tigercraft4/SHS-Z2M-Presence/.planning/phases/04-code-restructuring/04-03-PLAN.md

---
phase: 04-code-restructuring
plan: 03
type: execute
wave: 3
depends_on: ["04-01", "04-02"]
files_modified:
  - main/shs_config.h
  - main/shs_config.c
  - main/shs_sensor.h
  - main/shs_sensor.c
  - main/shs_button.h
  - main/shs_button.c
  - main/shs01.c
autonomous: true
requirements:
  - CS-02
  - CS-03
must_haves:
  truths:
    - "shs01.c reduced to ≤100 lines containing only app_main()"
    - "Zone attribute handler uses computed offsets instead of 30 switch cases"
    - "All sensor callbacks and tasks in shs_sensor module"
    - "Boot button task in shs_button module"
    - "Firmware compiles and produces identical Zigbee behavior"
  artifacts:
    - path: "main/shs_config.h"
      provides: "Config/NVS prototypes, attribute handler"
      contains: "shs_config_init"
    - path: "main/shs_config.c"
      provides: "NVS load/save, attribute handler with computed zone offsets, save_worker"
      contains: "shs_zb_attribute_handler"
    - path: "main/shs_sensor.h"
      provides: "Sensor task prototypes"
      contains: "shs_ld2410_task"
    - path: "main/shs_sensor.c"
      provides: "LD2410/LD2450 tasks, callbacks, zone occupancy logic"
      contains: "shs_on_ld2450_target_update"
    - path: "main/shs_button.h"
      provides: "Button task prototype"
      contains: "shs_boot_button_task"
    - path: "main/shs_button.c"
      provides: "Button task, LED flash, factory reset"
      contains: "shs_flash_led"
    - path: "main/shs01.c"
      provides: "Slim app_main only"
      min_lines: 30
  key_links:
    - from: "main/shs_config.c"
      to: "main/shs_zigbee.h"
      via: "attribute handler calls ZB helpers"
      pattern: "shs_zb_set_ou_delay_ep2"
    - from: "main/shs_sensor.c"
      to: "main/shs_zigbee.h"
      via: "sensor callbacks call ZB report functions"
      pattern: "shs_zb_set_binary_value"
    - from: "main/shs01.c"
      to: "main/shs_state.h"
      via: "app_main allocates and inits state"
      pattern: "shs_state_init"
---

<objective>
Create the remaining 3 modules (config, sensor, button) and reduce shs01.c to a slim app_main.

Purpose: Complete the module split (CS-02). Config module implements zone handler de-duplication with computed offsets (CS-03). All sensor and button logic moves to dedicated modules. shs01.c becomes the integration hub calling init functions.
Output: 6 new files + rewritten shs01.c (~80 lines)
</objective>

<execution_context>
@~/.copilot/get-shit-done/workflows/execute-plan.md
@~/.copilot/get-shit-done/templates/summary.md
</execution_context>

<context>
@.planning/PROJECT.md
@.planning/ROADMAP.md
@.planning/phases/04-code-restructuring/04-CONTEXT.md
@.planning/phases/04-code-restructuring/04-01-SUMMARY.md
@.planning/phases/04-code-restructuring/04-02-SUMMARY.md
</context>

<tasks>

<task type="auto">
  <name>Task 1: Create shs_config module with zone handler de-duplication (CS-03)</name>
  <files>main/shs_config.h, main/shs_config.c</files>
  <read_first>main/shs01.c (lines 309-690 — NVS helpers, zone save/load, zone apply; lines 1596-2020 — attribute handler with 30 zone switch cases), main/shs_state.h, main/shs_zigbee.h, main/shs01.h</read_first>
  <action>
**shs_config.h:**
```c
#ifndef SHS_CONFIG_H
#define SHS_CONFIG_H
#include "shs_state.h"
#include "esp_zigbee_core.h"

void shs_config_init(shs_state_t *state);
void shs_cfg_load_from_nvs(void);
void shs_zone_cfg_load_from_nvs(void);
void shs_zone_cfg_check_pending(void);
void shs_zone_cfg_schedule_apply(void);
void shs_save_worker(void *pv);

/* Zigbee action handler (registered by zigbee module) */
esp_err_t shs_zb_action_handler(esp_zb_core_action_callback_id_t callback_id, const void *message);
#endif
```

**shs_config.c:**

1. Module-static state pointer: `static shs_state_t *s_state = NULL;`

2. `shs_config_init(shs_state_t *state)` — stores state pointer.

3. Move all NVS helper functions from shs01.c:
   - `shs_time_reached()` (~L309)
   - `shs_cfg_save_u16()`, `shs_cfg_save_u8()`, `shs_cfg_save_i16()` (~L313-340)
   - `shs_save_enqueue()` (~L340)
   - `shs_cfg_sync_sens_proxies()` (~L346)
   - `shs_cfg_load_from_nvs()` (~L355)
   - `shs_zone_cfg_save_to_nvs()` (~L410) — the blob-based version from Phase 3
   - `shs_zone_cfg_load_from_nvs()` (~L454) — blob-first with legacy fallback
   - `shs_zone_cfg_schedule_apply()`, `shs_zone_cfg_check_pending()`, `shs_zone_cfg_apply_to_sensor()` (~L573-690)
   - `shs_apply_ld2410_config()` (~L1596)
   All functions change global access to `s_state->` fields.

4. **Zone attribute handler de-duplication (CS-03):**

   Replace the 30 copy-paste zone switch cases (~L1790-2015) with computed offset logic:

   ```c
   /* Zone attribute range: zone 1 = 0x0021-0x0027, zone N = 0x0020 + N*0x10 to +0x06 */
   static esp_err_t handle_zone_attr(uint16_t attr_id, uint8_t v8, int16_t v16s) {
       int zone_idx = -1;
       int field_offset = -1;

       if (attr_id >= SHS_ATTR_ZONE1_ENABLED && attr_id <= SHS_ATTR_ZONE1_TYPE_CFG) {
           zone_idx = 0;
           field_offset = attr_id - SHS_ATTR_ZONE1_ENABLED;
       } else {
           for (int z = 1; z < SHS_NUM_ZONES; z++) {
               uint16_t base = 0x0020 + z * 0x10;  /* zone2=0x0030, zone3=0x0040, etc. */
               if (attr_id >= base && attr_id <= base + 6) {
                   zone_idx = z;
                   field_offset = attr_id - base;
                   break;
               }
           }
       }

       if (zone_idx < 0) return ESP_ERR_NOT_FOUND;

       shs_zone_t *zone = &s_state->zones[zone_idx];
       if (xSemaphoreTake(s_state->zone_config_mutex, pdMS_TO_TICKS(50)) != pdTRUE)
           return ESP_OK;

       switch (field_offset) {
           case 0: zone->enabled = (v8 != 0); break;       /* ENABLED offset */
           case 1: zone->x1 = v16s; break;                  /* X1 offset */
           case 2: zone->y1 = v16s; break;                  /* Y1 offset */
           case 3: zone->x2 = v16s; break;                  /* X2 offset */
           case 4: zone->y2 = v16s; break;                  /* Y2 offset */
           /* case 5: targets — read-only, skip */
           case 6: zone->type = v8; break;                   /* TYPE offset */
           default: break;
       }
       xSemaphoreGive(s_state->zone_config_mutex);

       ESP_LOGI(TAG, "Zone %d field %d updated", zone_idx + 1, field_offset);
       shs_zone_cfg_schedule_apply();
       return ESP_OK;
   }
   ```

   This replaces ~220 lines of switch cases with ~30 lines. The attribute handler's config cluster section calls `handle_zone_attr()` for any attr_id >= 0x0020 that isn't in the non-zone config range.

5. Move `shs_zb_attribute_handler()` (~L1633) — the entire function. Non-zone cases (movement cooldown, occupancy clear, sensitivities, gates, position_reporting, min energy) stay as individual switch cases. Zone cases get replaced with the single `handle_zone_attr()` call.

6. Move `shs_zb_action_handler()` (~L2022) — wraps attribute handler callback.

7. Move `shs_save_worker()` (~L3261) — debounce logic, NVS write handling.
  </action>
  <acceptance_criteria>
    - main/shs_config.c contains `static esp_err_t handle_zone_attr(` function
    - main/shs_config.c does NOT contain `case SHS_ATTR_ZONE2_ENABLED` or any zone 2-5 individual switch cases
    - main/shs_config.c contains `s_state->zones[zone_idx]` zone array access
    - main/shs_config.c contains `shs_zone_cfg_save_to_nvs` with blob-based save
    - main/shs_config.c contains `shs_save_worker` function
    - main/shs_config.h contains `shs_zb_action_handler` prototype
  </acceptance_criteria>
  <verify>
    <automated>Select-String "case SHS_ATTR_ZONE[2-5]" main/shs_config.c should return 0 matches (zone duplication eliminated)</automated>
  </verify>
  <done>Config module compiles, zone handler uses computed offsets (CS-03), NVS save/load works via s_state</done>
</task>

<task type="auto">
  <name>Task 2: Create shs_sensor and shs_button modules + slim shs01.c</name>
  <files>main/shs_sensor.h, main/shs_sensor.c, main/shs_button.h, main/shs_button.c, main/shs01.c</files>
  <read_first>main/shs01.c (lines 769-1600 — sensor callbacks and processing; lines 2040-2215 — button task; lines 2272-2440 — sensor tasks; lines 3321-3400 — app_main), main/shs_state.h, main/shs_zigbee.h, main/shs_config.h, main/shs01.h</read_first>
  <action>
**shs_sensor.h:**
```c
#ifndef SHS_SENSOR_H
#define SHS_SENSOR_H
#include "shs_state.h"

void shs_sensor_init(shs_state_t *state);
void shs_ld2410_task(void *pvParameters);
void shs_ld2450_task(void *pvParameters);
#endif
```

**shs_sensor.c:**

1. Module-static: `static shs_state_t *s_state = NULL;`
2. `shs_sensor_init(shs_state_t *state)` — stores pointer.
3. Move all sensor code from shs01.c:
   - `is_valid_target()` (~L973)
   - `shs_point_in_zone()` (~L989)
   - `shs_target_in_interference_zone()` (~L998)
   - `shs_on_ld2450_target_update()` (~L1032) — the big target processing function. Zone access changes from `shs_zone1_x1` to `s_state->zones[0].x1`. The zone checking loop already iterates — this benefits most from the array. The 5× copy-paste zone-occupied checks collapse to a single `for (int z = 0; z < SHS_NUM_ZONES; z++)` loop.
   - `shs_on_ld2450_zone_update()` (~L1187)
   - `shs_ld2450_force_update()` (~L1310) — zone reporting uses loop over `s_state->zones[i]`
   - `shs_ld2410c_force_update()` (~L1445)
   - `shs_on_state_change()` (~L769) — LD2410C callback
   - `shs_ld2410_task()` (~L2272) — TWDT subscription, frame timeout monitoring
   - `shs_ld2450_task()` (~L2334) — TWDT subscription, connect/disconnect, health reporting
   All functions change global access to `s_state->` fields. ZB helper calls change to use the public API from shs_zigbee.h (already non-static in Plan 02).

**shs_button.h:**
```c
#ifndef SHS_BUTTON_H
#define SHS_BUTTON_H
#include "shs_state.h"

void shs_button_init(shs_state_t *state);
void shs_boot_button_task(void *pv);
#endif
```

**shs_button.c:**

1. Module-static: `static shs_state_t *s_state = NULL;`
2. `shs_button_init(shs_state_t *state)` — stores pointer.
3. Move from shs01.c:
   - `shs_flash_led()` (~L2040)
   - `shs_boot_button_task()` (~L2049) — factory reset, position toggle
   All global access → `s_state->`.

**Rewrite shs01.c to slim app_main (~80 lines):**

Replace the entire current 2980-line shs01.c with:

```c
/*
 * SHS01 Presence Sensor — Application Entry Point
 */

#include <string.h>
#include "esp_log.h"
#include "nvs_flash.h"
#include "freertos/FreeRTOS.h"
#include "freertos/task.h"
#include "esp_task_wdt.h"

#include "shs01.h"
#include "shs_state.h"
#include "shs_config.h"
#include "shs_zigbee.h"
#include "shs_sensor.h"
#include "shs_button.h"
#include "light_driver.h"

static const char *TAG = "SHS01";

/* Application state — single allocation, shared by all modules */
static shs_state_t g_state;

void app_main(void) {
    ESP_LOGI(TAG, "SHS01 Presence Sensor starting...");

    /* Initialize NVS */
    esp_err_t ret = nvs_flash_init();
    if (ret == ESP_ERR_NVS_NO_FREE_PAGES || ret == ESP_ERR_NVS_NEW_VERSION_FOUND) {
        ESP_ERROR_CHECK(nvs_flash_erase());
        ret = nvs_flash_init();
    }
    ESP_ERROR_CHECK(ret);

    /* Initialize shared state */
    shs_state_init(&g_state);

    /* Initialize modules (order matters — stores state pointer) */
    shs_config_init(&g_state);
    shs_zigbee_init(&g_state);
    shs_sensor_init(&g_state);
    shs_button_init(&g_state);

    /* Load configuration from NVS */
    shs_cfg_load_from_nvs();
    shs_zone_cfg_load_from_nvs();

    /* Initialize LED */
    light_driver_init(false);

    /* Initialize task watchdog (Phase 3: 10s timeout, panic on trigger) */
    esp_task_wdt_config_t twdt_config = {
        .timeout_ms = 10000,
        .trigger_panic = true,
        .idle_core_mask = 0,
    };
    ESP_ERROR_CHECK(esp_task_wdt_init(&twdt_config));

    /* Create tasks */
    xTaskCreate(shs_zigbee_task, "zigbee", 4096, NULL, 5, NULL);
    xTaskCreate(shs_ld2410_task, "ld2410", 3072, NULL, 4, NULL);
    xTaskCreate(shs_ld2450_task, "ld2450", 4096, NULL, 4, NULL);
    xTaskCreate(shs_boot_button_task, "button", 2048, NULL, 3, NULL);
    xTaskCreate(shs_save_worker, "save", 3072, NULL, 3, NULL);

    ESP_LOGI(TAG, "All tasks started");
}
```

Delete all other content from shs01.c. The file should be ~60-80 lines total.
  </action>
  <acceptance_criteria>
    - main/shs_sensor.c contains `shs_on_ld2450_target_update` with `s_state->zones[` array access
    - main/shs_sensor.c contains `shs_ld2410_task` and `shs_ld2450_task`
    - main/shs_button.c contains `shs_flash_led` and `shs_boot_button_task`
    - main/shs01.c is ≤100 lines
    - main/shs01.c contains `shs_state_init(&g_state)` and `static shs_state_t g_state`
    - main/shs01.c contains all 5 `xTaskCreate` calls
    - main/shs01.c does NOT contain `static bool shs_moving_state` or any sensor globals
  </acceptance_criteria>
  <verify>
    <automated>(Get-Content main/shs01.c | Measure-Object -Line).Lines should be ≤ 100</automated>
  </verify>
  <done>All 5 modules created, shs01.c is slim app_main only, firmware compiles with identical behavior</done>
</task>

</tasks>

<threat_model>
## Trust Boundaries

| Boundary | Description |
|---|---|
| Zigbee coordinator → attribute handler | Incoming attribute writes are validated in shs_config.c (type checks + range clamps) |
| UART → sensor callbacks | LD2410C/LD2450 UART data parsed by driver components (unchanged) |

## STRIDE Threat Register

| Threat ID | Category | Component | Disposition | Mitigation Plan |
|---|---|---|---|---|
| T-04-04 | T (Tampering) | Zone attributes | mitigate | handle_zone_attr validates zone_idx bounds (0 ≤ idx < SHS_NUM_ZONES) before array access |
| T-04-05 | I (Info Disclosure) | Diagnostic counters | accept | Counters are intentionally exposed via Zigbee for monitoring — no PII |
| T-04-06 | E (Elevation) | Module init order | mitigate | app_main enforces init order: state → config → zigbee → sensor → button. Each init stores s_state pointer — NULL if called out of order |
</threat_model>

<verification>
- shs01.c line count ≤ 100
- No sensor globals remain in shs01.c
- Zone target update uses loop over zones[] array (not 5× copy-paste)
- All 25 endpoints still created (verified by endpoint count in zigbee interview)
- Factory reset still works (button task in separate module)
</verification>

<success_criteria>
- shs01.c contains only app_main() (~80 lines) (CS-02)
- Zone attribute handler uses computed offsets (~30 lines vs ~220 lines) (CS-03)
- All modules compile, firmware behavior identical to pre-refactor
</success_criteria>

<output>
After completion, create `.planning/phases/04-code-restructuring/04-03-SUMMARY.md`
</output>
