tigercraft4/SHS-Z2M-Presence/.planning/phases/03-reliability-diagnostics/03-01-PLAN.md

---
phase: 03-reliability-diagnostics
plan: 01
type: execute
wave: 1
depends_on: []
files_modified:
  - sdkconfig.defaults
  - main/shs01.c
autonomous: true
requirements: [SH-01, NVS-02, NVS-03]

must_haves:
  truths:
    - "Task watchdog monitors both sensor tasks with 10s timeout"
    - "Frozen sensor task triggers automatic device reboot"
    - "LD2410C disconnect detected via UART frame timeout (3s threshold)"
    - "Zone config save uses single NVS blob key — atomic on power loss"
    - "NVS write failures logged and handled gracefully"
  artifacts:
    - path: "sdkconfig.defaults"
      provides: "TWDT configuration"
      contains: "CONFIG_ESP_TASK_WDT_EN=y"
    - path: "main/shs01.c"
      provides: "TWDT init, sensor reset calls, NVS blob batching"
  key_links:
    - from: "shs_ld2410_task loop"
      to: "esp_task_wdt_reset()"
      via: "called every 20ms iteration"
      pattern: "esp_task_wdt_reset"
    - from: "shs_ld2450_task loop"
      to: "esp_task_wdt_reset()"
      via: "called every 20ms iteration"
      pattern: "esp_task_wdt_reset"
    - from: "shs_zone_cfg_save_to_nvs"
      to: "nvs_set_blob"
      via: "packed struct serialization"
      pattern: "nvs_set_blob"
---

<objective>
Add task watchdog monitoring for sensor tasks and batch zone NVS writes into a single atomic blob.

Purpose: Detect frozen sensor tasks (UART hardware hangs) and ensure zone configuration is never partially written on power loss.
Output: TWDT-protected sensor loops + atomic NVS zone persistence + LD2410C disconnect detection via frame timestamps.
</objective>

<execution_context>
@~/.copilot/get-shit-done/workflows/execute-plan.md
@~/.copilot/get-shit-done/templates/summary.md
</execution_context>

<context>
@.planning/PROJECT.md
@.planning/ROADMAP.md
@.planning/STATE.md
@.planning/phases/03-reliability-diagnostics/03-CONTEXT.md
</context>

<tasks>

<task type="auto">
  <name>Task 1: Task Watchdog + LD2410C frame timestamp</name>
  <files>sdkconfig.defaults, main/shs01.c</files>
  <read_first>
    - sdkconfig.defaults (current config entries)
    - main/shs01.c §L3160-3230 (app_main — initialization order)
    - main/shs01.c §L2169-2210 (shs_ld2410_task — loop structure)
    - main/shs01.c §L2213-2310 (shs_ld2450_task — loop structure)
  </read_first>
  <action>
**sdkconfig.defaults** — append TWDT config (per D-01, D-03, D-04):
```
# Task Watchdog
CONFIG_ESP_TASK_WDT_EN=y
CONFIG_ESP_TASK_WDT_PANIC=y
CONFIG_ESP_TASK_WDT_TIMEOUT_S=10
CONFIG_ESP_TASK_WDT_CHECK_IDLE_TASK=n
```
`CHECK_IDLE_TASK=n` because ESP32-C6 is single-core and the idle task may starve under Zigbee load.

**main/shs01.c** — add `#include "esp_task_wdt.h"` to includes.

**main/shs01.c** — add LD2410C frame timestamp tracking (per D-06):
Add near existing diagnostic counters (after line ~149):
```c
/* LD2410C health monitoring — frame-based disconnect detection (D-06) */
static uint32_t shs_ld2410c_last_frame_ms = 0;
static bool shs_ld2410c_connected = false;
#define SHS_LD2410C_FRAME_TIMEOUT_MS  3000  /* 3s = ~30 missed frames at 100ms interval */
```

**main/shs01.c** — in `app_main()`, after mutex creation and before `xTaskCreate(shs_zigbee_task, ...)`:
```c
/* Initialize Task Watchdog Timer (per D-01, D-03, D-04) */
esp_task_wdt_config_t twdt_config = {
    .timeout_ms = 10000,
    .idle_core_mask = 0,
    .trigger_panic = true,
};
ESP_ERROR_CHECK(esp_task_wdt_init(&twdt_config));
ESP_LOGI(SHS_TAG, "Task watchdog initialized (10s timeout, panic on trigger)");
```

**main/shs01.c** — in `shs_ld2410_task()`, at start of function (after `shs_apply_ld2410_config()`):
```c
/* Subscribe this task to TWDT (per D-02) */
ESP_ERROR_CHECK(esp_task_wdt_add(NULL));
```
In the `while(1)` loop, after `ld2410_process()`:
```c
esp_task_wdt_reset();
```
Add LD2410C frame timestamp update — after the `ld2410_process()` + `esp_task_wdt_reset()` block, use the existing `connected` variable:
```c
/* Update LD2410C frame timestamp for disconnect detection (D-06) */
if (connected) {
    shs_ld2410c_last_frame_ms = now;
    if (!shs_ld2410c_connected) {
        shs_ld2410c_connected = true;
        ESP_LOGI(SHS_TAG, "LD2410C connected (frame received)");
    }
} else if (shs_ld2410c_connected && shs_ld2410c_last_frame_ms > 0 &&
           (now - shs_ld2410c_last_frame_ms) > SHS_LD2410C_FRAME_TIMEOUT_MS) {
    shs_ld2410c_connected = false;
    ESP_LOGW(SHS_TAG, "LD2410C disconnected (no frame for %lu ms)",
             (unsigned long)(now - shs_ld2410c_last_frame_ms));
}
```

**main/shs01.c** — in `shs_ld2450_task()`, at start of function (after `shs_zone_cfg_apply_to_sensor()`):
```c
/* Subscribe this task to TWDT (per D-02) */
ESP_ERROR_CHECK(esp_task_wdt_add(NULL));
```
In the `while(1)` loop, after `ld2450_process()`:
```c
esp_task_wdt_reset();
```
  </action>
  <verify>
    <automated>grep -c "esp_task_wdt" main/shs01.c</automated>
  </verify>
  <acceptance_criteria>
    - sdkconfig.defaults contains `CONFIG_ESP_TASK_WDT_EN=y`
    - sdkconfig.defaults contains `CONFIG_ESP_TASK_WDT_PANIC=y`
    - sdkconfig.defaults contains `CONFIG_ESP_TASK_WDT_TIMEOUT_S=10`
    - shs01.c contains `#include "esp_task_wdt.h"`
    - shs01.c contains `esp_task_wdt_init` call in app_main
    - shs01.c contains `esp_task_wdt_add(NULL)` in shs_ld2410_task
    - shs01.c contains `esp_task_wdt_add(NULL)` in shs_ld2450_task
    - shs01.c contains `esp_task_wdt_reset()` in both sensor task loops
    - shs01.c contains `SHS_LD2410C_FRAME_TIMEOUT_MS` define (3000)
    - shs01.c contains `shs_ld2410c_connected` variable
  </acceptance_criteria>
  <done>Both sensor tasks subscribed to TWDT. LD2410C disconnect detection via 3s frame timeout. Device will auto-reboot if either sensor task freezes for 10s.</done>
</task>

<task type="auto">
  <name>Task 2: NVS zone config batching + error handling</name>
  <files>main/shs01.c</files>
  <read_first>
    - main/shs01.c §L390-440 (shs_zone_cfg_save_to_nvs — current 31-write implementation)
    - main/shs01.c §L440-520 (shs_zone_cfg_load_from_nvs — current per-key loading)
    - main/shs01.c §L3100-3160 (shs_save_worker — zone save case handler)
    - main/shs01.c §L280-340 (NVS helper functions)
    - main/shs01.c §L3206 (save_worker stack size 3072)
  </read_first>
  <action>
**NVS batching with blob** (per D-09 choosing blob approach, D-10 atomicity):

Define a packed struct near the zone config section:
```c
/* Packed zone config for atomic NVS blob save (D-10) */
typedef struct __attribute__((packed)) {
    uint8_t zone_type;
    struct __attribute__((packed)) {
        uint8_t enabled;
        int16_t x1, y1, x2, y2;
        uint8_t type;
    } zones[5];
} shs_zone_cfg_blob_t;  /* 51 bytes — safe for 3072B save_worker stack */

#define SHS_NVS_KEY_ZONE_BLOB "zone_blob"
```

**Replace `shs_zone_cfg_save_to_nvs()`** — the entire function body becomes:
```c
static void shs_zone_cfg_save_to_nvs(void) {
    shs_zone_cfg_blob_t blob;
    blob.zone_type = shs_zone_type;

    /* Pack zone data — read under zone_config_mutex assumed by caller (save_worker) */
    const bool     *en[]  = {&shs_zone1_enabled, &shs_zone2_enabled, &shs_zone3_enabled, &shs_zone4_enabled, &shs_zone5_enabled};
    const int16_t  *x1[]  = {&shs_zone1_x1, &shs_zone2_x1, &shs_zone3_x1, &shs_zone4_x1, &shs_zone5_x1};
    const int16_t  *y1[]  = {&shs_zone1_y1, &shs_zone2_y1, &shs_zone3_y1, &shs_zone4_y1, &shs_zone5_y1};
    const int16_t  *x2[]  = {&shs_zone1_x2, &shs_zone2_x2, &shs_zone3_x2, &shs_zone4_x2, &shs_zone5_x2};
    const int16_t  *y2[]  = {&shs_zone1_y2, &shs_zone2_y2, &shs_zone3_y2, &shs_zone4_y2, &shs_zone5_y2};
    const uint8_t  *tp[]  = {&shs_zone1_type, &shs_zone2_type, &shs_zone3_type, &shs_zone4_type, &shs_zone5_type};

    for (int i = 0; i < 5; i++) {
        blob.zones[i].enabled = *en[i] ? 1 : 0;
        blob.zones[i].x1 = *x1[i];
        blob.zones[i].y1 = *y1[i];
        blob.zones[i].x2 = *x2[i];
        blob.zones[i].y2 = *y2[i];
        blob.zones[i].type = *tp[i];
    }

    nvs_handle_t h;
    esp_err_t err = nvs_open("shs_cfg", NVS_READWRITE, &h);
    if (err != ESP_OK) {
        ESP_LOGW(SHS_TAG, "NVS open failed for zone save: %s", esp_err_to_name(err));
        return;
    }

    err = nvs_set_blob(h, SHS_NVS_KEY_ZONE_BLOB, &blob, sizeof(blob));
    if (err != ESP_OK) {
        ESP_LOGW(SHS_TAG, "NVS zone blob write failed: %s", esp_err_to_name(err));
        nvs_close(h);
        return;
    }

    err = nvs_commit(h);
    if (err != ESP_OK) {
        ESP_LOGW(SHS_TAG, "NVS zone blob commit failed: %s", esp_err_to_name(err));
    }
    nvs_close(h);
    ESP_LOGI(SHS_TAG, "Zone config saved to NVS (atomic blob, %u bytes)", (unsigned)sizeof(blob));
}
```

**Update `shs_zone_cfg_load_from_nvs()`** — try blob first, fall back to legacy keys for migration (per D-11 error handling):
```c
static void shs_zone_cfg_load_from_nvs(void) {
    nvs_handle_t h;
    if (nvs_open("shs_cfg", NVS_READONLY, &h) != ESP_OK) {
        ESP_LOGI(SHS_TAG, "No zone config in NVS, using defaults");
        return;
    }

    /* Try blob format first (new atomic format) */
    shs_zone_cfg_blob_t blob;
    size_t blob_len = sizeof(blob);
    esp_err_t err = nvs_get_blob(h, SHS_NVS_KEY_ZONE_BLOB, &blob, &blob_len);
    if (err == ESP_OK && blob_len == sizeof(blob)) {
        shs_zone_type = blob.zone_type;
        bool     *en[]  = {&shs_zone1_enabled, &shs_zone2_enabled, &shs_zone3_enabled, &shs_zone4_enabled, &shs_zone5_enabled};
        int16_t  *x1[]  = {&shs_zone1_x1, &shs_zone2_x1, &shs_zone3_x1, &shs_zone4_x1, &shs_zone5_x1};
        int16_t  *y1[]  = {&shs_zone1_y1, &shs_zone2_y1, &shs_zone3_y1, &shs_zone4_y1, &shs_zone5_y1};
        int16_t  *x2[]  = {&shs_zone1_x2, &shs_zone2_x2, &shs_zone3_x2, &shs_zone4_x2, &shs_zone5_x2};
        int16_t  *y2[]  = {&shs_zone1_y2, &shs_zone2_y2, &shs_zone3_y2, &shs_zone4_y2, &shs_zone5_y2};
        uint8_t  *tp[]  = {&shs_zone1_type, &shs_zone2_type, &shs_zone3_type, &shs_zone4_type, &shs_zone5_type};
        for (int i = 0; i < 5; i++) {
            *en[i] = blob.zones[i].enabled ? true : false;
            *x1[i] = blob.zones[i].x1;
            *y1[i] = blob.zones[i].y1;
            *x2[i] = blob.zones[i].x2;
            *y2[i] = blob.zones[i].y2;
            *tp[i] = blob.zones[i].type;
        }
        nvs_close(h);
        ESP_LOGI(SHS_TAG, "Zone config loaded from NVS (blob format)");
        return;
    }

    /* Fall back to legacy per-key format (migration path) */
    ESP_LOGI(SHS_TAG, "No zone blob in NVS, trying legacy keys...");
    /* ... keep the existing per-key loading code below this point ... */
```
Keep ALL existing per-key `nvs_get_*` calls after this fallback comment — they handle pre-blob firmware configs. After loading from legacy keys, close NVS and then trigger a blob save to migrate:
```c
    nvs_close(h);
    ESP_LOGI(SHS_TAG, "Zone config loaded from NVS (legacy format, will migrate to blob)");
    /* Migrate to blob format on next save */
    shs_zone_cfg_save_to_nvs();
}
```

**NVS error handling** (per D-11): All `nvs_open`/`nvs_set_*`/`nvs_commit` calls in the helper functions (`shs_cfg_save_u16`, `shs_cfg_save_u8`, `shs_cfg_save_i16`) should log warnings on failure. Currently they silently return. Add `ESP_LOGW` on failure to each helper:
- `shs_cfg_save_u16`: change `if (nvs_open(...) != ESP_OK) return;` to `if (... != ESP_OK) { ESP_LOGW(SHS_TAG, "NVS save_u16 open failed: %s", esp_err_to_name(err)); return; }` — capture err from nvs_open.
- Same pattern for `shs_cfg_save_u8` and `shs_cfg_save_i16`.
  </action>
  <verify>
    <automated>grep -c "nvs_set_blob\|zone_blob\|shs_zone_cfg_blob_t\|ESP_LOGW.*NVS" main/shs01.c</automated>
  </verify>
  <acceptance_criteria>
    - shs01.c contains `shs_zone_cfg_blob_t` typedef with `__attribute__((packed))`
    - shs01.c contains `SHS_NVS_KEY_ZONE_BLOB` define as "zone_blob"
    - shs_zone_cfg_save_to_nvs uses `nvs_set_blob` (not 31 individual nvs_set calls)
    - shs_zone_cfg_load_from_nvs tries `nvs_get_blob` first, falls back to legacy keys
    - NVS helper functions (`shs_cfg_save_u16`, `shs_cfg_save_u8`, `shs_cfg_save_i16`) log `ESP_LOGW` on open/write failures
    - No `nvs_set_u8` or `nvs_set_i16` calls remain in `shs_zone_cfg_save_to_nvs`
  </acceptance_criteria>
  <done>Zone config saves atomically via single NVS blob (51 bytes). Legacy per-key configs auto-migrate on first boot. All NVS failures logged with ESP_LOGW.</done>
</task>

</tasks>

<threat_model>
## Trust Boundaries

| Boundary | Description |
|---|---|
| NVS flash ↔ firmware | NVS blob could be corrupted (flash wear, power loss during write) |
| UART ↔ sensor tasks | Sensor hardware can hang, stop sending frames |

## STRIDE Threat Register

| Threat ID | Category | Component | Disposition | Mitigation Plan |
|---|---|---|---|---|
| T-03-01 | D (Denial of Service) | shs_ld2410_task / shs_ld2450_task | mitigate | TWDT auto-reboot on frozen task (10s timeout, CONFIG_ESP_TASK_WDT_PANIC=y) |
| T-03-02 | T (Tampering) | NVS zone_blob | accept | NVS corruption handled by load fallback to defaults; mains-powered device, flash wear is low risk |
| T-03-03 | D (Denial of Service) | NVS write failure | mitigate | Log warning + continue with in-memory values; device operates normally without persistent save |
</threat_model>

<verification>
- `grep "CONFIG_ESP_TASK_WDT" sdkconfig.defaults` returns 4 entries
- `grep -c "esp_task_wdt_reset" main/shs01.c` returns >= 2 (one per sensor task)
- `grep -c "esp_task_wdt_add" main/shs01.c` returns >= 2
- `grep "nvs_set_blob" main/shs01.c` returns at least 1 match
- `grep "nvs_get_blob" main/shs01.c` returns at least 1 match
- No `nvs_set_u8\|nvs_set_i16` calls inside `shs_zone_cfg_save_to_nvs` function
- `idf.py build` compiles without errors
</verification>

<success_criteria>
- Device reboots automatically when a sensor task freezes for 10+ seconds
- LD2410C disconnect detected passively via frame timeout (3 seconds = ~30 missed frames)
- Zone configuration saved as single 51-byte NVS blob — atomic on power loss
- Pre-blob NVS configs auto-migrate to blob format on first boot
- NVS failures produce ESP_LOGW log lines (never silent failures)
</success_criteria>

<output>
After completion, create `.planning/phases/03-reliability-diagnostics/03-01-SUMMARY.md`
</output>
