tigercraft4/SHS-Z2M-Presence/.planning/phases/02-sensor-filters/02-02-PLAN.md

---
phase: 02-sensor-filters
plan: 02
type: execute
wave: 2
depends_on:
  - 02-01
files_modified:
  - zigbee2mqtt/external_converters/shs01_enhanced.js
  - zigbee2mqtt/external_converters/shs01_enhanced.mjs
autonomous: true
requirements:
  - CC-02

must_haves:
  truths:
    - "Z2M converter reads X coordinates directly without subtracting 3000"
    - "Both .js and .mjs converters updated identically"
    - "Z2M shows correct signed X values (−3000 to +3000) after firmware + converter update"
  artifacts:
    - path: "zigbee2mqtt/external_converters/shs01_enhanced.js"
      provides: "Updated fromZigbee converter without bias subtraction"
    - path: "zigbee2mqtt/external_converters/shs01_enhanced.mjs"
      provides: "Updated ESM converter without bias subtraction"
  key_links:
    - from: "main/shs01.c (position reporting)"
      to: "zigbee2mqtt converter"
      via: "genAnalogInput presentValue on EP8-16"
      pattern: "Math.round(value)"
---

<objective>
Update Z2M external converters to match the int16 encoding change — remove the −3000 bias subtraction from X coordinate parsing.

Purpose: Plan 01 removed the +3000 bias from firmware. The converters must stop subtracting 3000 or X values will be wrong by 3000mm.
Output: Both .js and .mjs converters decode X coordinates as direct values.
</objective>

<execution_context>
@~/.copilot/get-shit-done/workflows/execute-plan.md
@~/.copilot/get-shit-done/templates/summary.md
</execution_context>

<context>
@.planning/PROJECT.md
@.planning/ROADMAP.md
@.planning/phases/02-sensor-filters/02-01-PLAN.md
@zigbee2mqtt/external_converters/shs01_enhanced.js
@zigbee2mqtt/external_converters/shs01_enhanced.mjs

<interfaces>
<!-- Current converter bias subtraction code (identical in .js and .mjs) -->

From zigbee2mqtt/external_converters/shs01_enhanced.js (lines 214-227):
```javascript
// WORKAROUND: X coordinates are transmitted with +3000 bias to avoid
// negative float issues in Zigbee stack. Subtract 3000 to restore original.
if (msg.data.hasOwnProperty('presentValue')) {
    switch (ep) {
        case EP_T1_X: result.target1_x = Math.round(value) - 3000; break;
        case EP_T1_Y: result.target1_y = Math.round(value); break;
        case EP_T1_DIST: result.target1_distance = Math.round(value); break;
        case EP_T2_X: result.target2_x = Math.round(value) - 3000; break;
        case EP_T2_Y: result.target2_y = Math.round(value); break;
        case EP_T2_DIST: result.target2_distance = Math.round(value); break;
        case EP_T3_X: result.target3_x = Math.round(value) - 3000; break;
        case EP_T3_Y: result.target3_y = Math.round(value); break;
        case EP_T3_DIST: result.target3_distance = Math.round(value); break;
    }
}
```
</interfaces>
</context>

<tasks>

<task type="auto">
  <name>Task 1: Remove bias subtraction from .js converter</name>
  <files>zigbee2mqtt/external_converters/shs01_enhanced.js</files>
  <read_first>zigbee2mqtt/external_converters/shs01_enhanced.js (lines 210-230 for the bias subtraction block)</read_first>
  <action>
1. Remove the WORKAROUND comment block (lines 214-215):
   ```
   // WORKAROUND: X coordinates are transmitted with +3000 bias to avoid
   // negative float issues in Zigbee stack. Subtract 3000 to restore original.
   ```

2. Change the three X coordinate lines to remove `- 3000`:
   - `case EP_T1_X: result.target1_x = Math.round(value) - 3000; break;`
     → `case EP_T1_X: result.target1_x = Math.round(value); break;`
   - `case EP_T2_X: result.target2_x = Math.round(value) - 3000; break;`
     → `case EP_T2_X: result.target2_x = Math.round(value); break;`
   - `case EP_T3_X: result.target3_x = Math.round(value) - 3000; break;`
     → `case EP_T3_X: result.target3_x = Math.round(value); break;`

No other changes — Y and distance lines already read values directly.
  </action>
  <verify>
    <automated>grep -n "3000" zigbee2mqtt/external_converters/shs01_enhanced.js</automated>
  </verify>
  <acceptance_criteria>
    - No `- 3000` in any `target*_x` assignment
    - No "WORKAROUND" or "bias" comment in position parsing section
    - `result.target1_x = Math.round(value);` (no subtraction)
    - `result.target2_x = Math.round(value);` (no subtraction)
    - `result.target3_x = Math.round(value);` (no subtraction)
    - Y and distance parsing unchanged: `Math.round(value)` without modification
  </acceptance_criteria>
  <done>JS converter reads X coordinates directly without bias subtraction</done>
</task>

<task type="auto">
  <name>Task 2: Remove bias subtraction from .mjs converter</name>
  <files>zigbee2mqtt/external_converters/shs01_enhanced.mjs</files>
  <read_first>zigbee2mqtt/external_converters/shs01_enhanced.mjs (lines 210-230 for the bias subtraction block)</read_first>
  <action>
Apply identical changes as Task 1 to the ESM (.mjs) converter:

1. Remove the WORKAROUND comment block.
2. Change the three X coordinate lines to remove `- 3000`:
   - `case EP_T1_X: result.target1_x = Math.round(value); break;`
   - `case EP_T2_X: result.target2_x = Math.round(value); break;`
   - `case EP_T3_X: result.target3_x = Math.round(value); break;`
  </action>
  <verify>
    <automated>grep -n "3000" zigbee2mqtt/external_converters/shs01_enhanced.mjs</automated>
  </verify>
  <acceptance_criteria>
    - No `- 3000` in any `target*_x` assignment
    - No "WORKAROUND" or "bias" comment in position parsing section
    - Changes identical to Task 1 in the .js file
  </acceptance_criteria>
  <done>MJS converter reads X coordinates directly without bias subtraction</done>
</task>

</tasks>

<threat_model>
## Trust Boundaries

| Boundary | Description |
|---|---|
| Zigbee → Z2M | Data from device parsed by converter — minimal trust concern (local network) |

## STRIDE Threat Register

| Threat ID | Category | Component | Disposition | Mitigation Plan |
|---|---|---|---|---|
| T-02-04 | T (Tampering) | Converter parsing | accept | Converter runs locally in Z2M process; external converters are user-deployed files |
</threat_model>

<verification>
- `grep -c "\- 3000" zigbee2mqtt/external_converters/shs01_enhanced.js` returns 0
- `grep -c "\- 3000" zigbee2mqtt/external_converters/shs01_enhanced.mjs` returns 0
- `grep "Math.round(value)" zigbee2mqtt/external_converters/shs01_enhanced.js | grep "target.*_x"` shows direct assignment
</verification>

<success_criteria>
- Both .js and .mjs converters decode X coordinates as direct values
- No reference to 3000 bias in converter position parsing code
- Y and distance parsing unmodified
</success_criteria>

<output>
After completion, create `.planning/phases/02-sensor-filters/02-02-SUMMARY.md`
</output>
