tigercraft4/SHS-Z2M-Presence/.planning/STATE.md

---
gsd_state_version: 1.0
milestone: v1.0
milestone_name: milestone
status: complete
stopped_at: Phase 4 complete — all 4 phases done
last_updated: "2025-01-XX"
last_activity: 2025-01-XX -- Phase 4 code restructuring complete
progress:
  total_phases: 4
  completed_phases: 4
  total_plans: 9
  completed_plans: 9
  percent: 100
---

# Project State

## Project Reference

See: .planning/PROJECT.md (updated 2026-04-30)

**Core value:** Reliable, crash-free presence detection — every occupancy event reported correctly to Zigbee2MQTT, zero silent data loss.
**Current focus:** Milestone complete

## Current Position

Phase: 4 (complete)
Plan: All 3 plans executed
Status: Milestone complete
Last activity: 2025-01-XX

Progress: [████████████████████] 100% (All phases complete)

## Performance Metrics

**Velocity:**

- Total plans completed: 9
- Average duration: —
- Total execution time: —

**By Phase:**

| Phase | Plans | Total | Avg/Plan |
|---|---|---|---|
| 1 | 2 | — | — |
| 02 | 2 | - | - |
| 03 | 2 | - | - |
| 04 | 3 | - | - |

**Recent Trend:**

- Last 5 plans: —
- Trend: —

*Updated after each plan completion*

## Accumulated Context

### Decisions

Decisions are logged in PROJECT.md Key Decisions table.
Recent decisions affecting current work:

- [Init]: Fix crash bugs before refactoring — uninitialized mutex causes immediate crash; must be first
- [Init]: Refactor into modules after bug fixes — reduces risk of introducing new bugs during restructure
- [Init]: Keep 25 endpoint model — changing endpoint count breaks existing Z2M pairings

### Pending Todos

None yet.

### Blockers/Concerns

- Zigbee lock contention: no data on actual lock hold times during commissioning/route discovery. Measure during Phase 1.
- LD2410C failure modes: no prior art in codebase for health monitoring. Characterize during Phase 3 planning.
- save_worker stack at 3072B is borderline for batched NVS. Monitor with `uxTaskGetStackHighWaterMark()`.

## Deferred Items

Items acknowledged and carried forward:

| Category | Item | Status | Deferred At |
|---|---|---|---|
| *(none)* | | | |

## Session Continuity

Last session: 2026-04-30
Stopped at: Roadmap created, ready for Phase 1 planning
Resume file: None
