tigercraft4/SHS-Z2M-Presence/.planning/phases/04-code-restructuring/04-01-SUMMARY.md

---
phase: 04-code-restructuring
plan: 01
status: complete
---

# Plan 04-01 Summary: Shared State Struct

## What Was Built
Created `shs_state.h` and `shs_state.c` — the foundation for the module split. Consolidates ~100 static globals from shs01.c into a single `shs_state_t` struct with:

- `shs_zone_t zones[SHS_NUM_ZONES]` array replacing 30+ individual zone variables
- `shs_save_evt_t` enum and `shs_save_msg_t` struct for NVS save worker
- `shs_zone_cfg_blob_t` packed struct for atomic NVS zone saves
- `shs_state_init()` creating both mutexes, save queue, and setting all defaults

## Key Files
- `main/shs_state.h` — Type definitions, constants, init prototype
- `main/shs_state.c` — Init function with mutex creation and defaults

## Decisions
- Zone defaults match existing code: x1=-1500, y1=0, x2=1500, y2=3000
- Sensor config defaults preserved exactly (moving_sens_0_100=60, etc.)
- `diag_init_zero` and `health_init_false` kept as struct fields for Zigbee attr registration

## Self-Check: PASSED
- `shs_state.h` contains `typedef struct` for shs_zone_t and shs_state_t
- `SHS_NUM_ZONES` defined as 5
- `SemaphoreHandle_t target_data_mutex` present
- `shs_zone_t zones[SHS_NUM_ZONES]` present
- `void shs_state_init(shs_state_t *state)` declared
- `shs_save_evt_t` enum and `shs_save_msg_t` struct present
