tigercraft4/SHS-Z2M-Presence/.planning/phases/04-code-restructuring/04-01-PLAN.md

---
phase: 04-code-restructuring
plan: 01
type: execute
wave: 1
depends_on: []
files_modified:
  - main/shs_state.h
  - main/shs_state.c
autonomous: true
requirements:
  - CS-01
must_haves:
  truths:
    - "shs_state_t struct compiles and contains all ~100 globals from shs01.c"
    - "shs_zone_t sub-struct has zones[SHS_NUM_ZONES] array with 8 fields per zone"
    - "shs_state_init() creates both mutexes and sets default values"
  artifacts:
    - path: "main/shs_state.h"
      provides: "shs_state_t and shs_zone_t type definitions, SHS_NUM_ZONES constant, init prototype"
      contains: "typedef struct"
    - path: "main/shs_state.c"
      provides: "shs_state_init() implementation"
      contains: "xSemaphoreCreateMutex"
  key_links:
    - from: "main/shs_state.h"
      to: "main/shs_state.c"
      via: "shs_state_init declaration/definition"
      pattern: "void shs_state_init"
---

<objective>
Create the shared state struct that all other modules will depend on.

Purpose: CS-01 requires consolidating ~100 static globals into `shs_state_t` with `shs_zone_t zones[5]` array. This is the foundation for the entire refactoring — all subsequent plans import this header.
Output: `main/shs_state.h` (types + prototypes) and `main/shs_state.c` (init function)
</objective>

<execution_context>
@~/.copilot/get-shit-done/workflows/execute-plan.md
@~/.copilot/get-shit-done/templates/summary.md
</execution_context>

<context>
@.planning/PROJECT.md
@.planning/ROADMAP.md
@.planning/STATE.md
@.planning/phases/04-code-restructuring/04-CONTEXT.md
</context>

<tasks>

<task type="auto">
  <name>Task 1: Create shs_state.h with struct definitions</name>
  <files>main/shs_state.h</files>
  <read_first>main/shs01.c (lines 44-283 — all static globals to consolidate), main/shs01.h (endpoint/attribute/cluster defines)</read_first>
  <action>
Create `main/shs_state.h` with:

1. Include guard `#ifndef SHS_STATE_H` / `#define SHS_STATE_H`
2. Required includes: `stdbool.h`, `stdint.h`, `freertos/FreeRTOS.h`, `freertos/semphr.h`, `freertos/queue.h`, `components/ld2450/include/ld2450.h` (for `ld2450_target_t`)
3. `#define SHS_NUM_ZONES 5`
4. `#define SHS_MAX_TARGETS 3`
5. `#define SHS_LD2410C_FRAME_TIMEOUT_MS 3000`

6. NVS save event enum (moved from shs01.c):
```c
typedef enum {
    SHS_SAVE_IMMEDIATE_U16,
    SHS_SAVE_DEBOUNCE_SENS_MOVE,
    SHS_SAVE_DEBOUNCE_SENS_STATIC,
    SHS_SAVE_DEBOUNCE_GATE_MOVE,
    SHS_SAVE_DEBOUNCE_GATE_STATIC,
    SHS_SAVE_ZONE_CONFIG,
} shs_save_evt_t;

typedef struct {
    shs_save_evt_t type;
    uint16_t       u16;
} shs_save_msg_t;
```

7. Zone sub-struct (per D-05):
```c
typedef struct {
    bool    enabled;
    int16_t x1, y1, x2, y2;
    uint8_t type;
    uint8_t targets;
    bool    occupied;
} shs_zone_t;
```

8. NVS zone config blob struct (moved from shs01.c, used by NVS batching):
```c
typedef struct __attribute__((packed)) {
    uint8_t version;
    uint8_t zone_type;
    struct __attribute__((packed)) {
        uint8_t enabled;
        int16_t x1, y1, x2, y2;
        uint8_t type;
    } zones[SHS_NUM_ZONES];
} shs_zone_cfg_blob_t;
```

9. Main state struct `shs_state_t` (per D-04, D-06 — flat with zone array):
```c
typedef struct {
    /* Mutexes */
    SemaphoreHandle_t target_data_mutex;
    SemaphoreHandle_t zone_config_mutex;

    /* Save worker queue */
    QueueHandle_t save_q;

    /* Current targets (from LD2450) */
    ld2450_target_t current_targets[SHS_MAX_TARGETS];
    uint8_t current_target_count;

    /* LD2410C config */
    uint16_t movement_cooldown_sec;
    uint16_t occupancy_clear_sec;
    uint32_t moving_cooldown_until;
    uint32_t static_cooldown_until;
    uint8_t  moving_sens_0_100;
    uint8_t  static_sens_0_100;
    uint16_t moving_max_gate;
    uint16_t static_max_gate;
    uint16_t sens_mv_0_10;
    uint16_t sens_st_0_10;
    volatile bool position_reporting;
    uint16_t min_moving_energy;
    uint16_t min_static_energy;

    /* LD2450 state */
    bool ld2450_connected;
    char firmware_version[20];
    bool ld2450_occupancy;
    uint8_t ld2450_target_count;

    /* LD2410C state */
    bool moving_state;
    bool static_state;
    bool occupancy_state;

    /* Zigbee state */
    volatile bool zb_ready;
    volatile bool zb_connected;
    volatile bool zb_rejoin_pending;
    uint32_t last_successful_tx;

    /* Diagnostic counters */
    uint32_t lock_success_count;
    uint32_t lock_fail_count;
    uint32_t lock_consecutive_fails;
    uint32_t tx_success_count;
    uint32_t tx_fail_count;

    /* LD2410C health */
    uint32_t ld2410c_last_frame_ms;
    bool ld2410c_connected;

    /* Zones (per D-04, D-05) */
    uint8_t zone_type;  /* global zone mode */
    shs_zone_t zones[SHS_NUM_ZONES];

    /* Zone config scheduling */
    uint32_t zone_cfg_pending_until;
    bool zone_cfg_pending;
    bool zone_cfg_save_needed;

    /* Position smoothing */
    uint32_t last_position_update_ms;
    float smoothed_x[SHS_MAX_TARGETS];
    float smoothed_y[SHS_MAX_TARGETS];
    int16_t last_reported_x[SHS_MAX_TARGETS];
    int16_t last_reported_y[SHS_MAX_TARGETS];
    uint16_t last_reported_dist[SHS_MAX_TARGETS];

    /* Static init values for Zigbee attribute registration */
    uint32_t diag_init_zero;
    bool health_init_false;
} shs_state_t;
```

10. Function prototype:
```c
void shs_state_init(shs_state_t *state);
```

11. Close include guard `#endif`
  </action>
  <acceptance_criteria>
    - main/shs_state.h exists and contains `typedef struct` for both `shs_zone_t` and `shs_state_t`
    - main/shs_state.h contains `#define SHS_NUM_ZONES 5`
    - main/shs_state.h contains `SemaphoreHandle_t target_data_mutex`
    - main/shs_state.h contains `shs_zone_t zones[SHS_NUM_ZONES]`
    - main/shs_state.h contains `void shs_state_init(shs_state_t *state)`
    - main/shs_state.h contains `shs_save_evt_t` enum and `shs_save_msg_t` struct
    - main/shs_state.h contains `shs_zone_cfg_blob_t` packed struct
  </acceptance_criteria>
  <verify>
    <automated>grep -c "typedef struct" main/shs_state.h returns >= 3 (shs_zone_t, shs_zone_cfg_blob_t, shs_state_t)</automated>
  </verify>
  <done>shs_state.h compiles, contains all type definitions for the shared state struct</done>
</task>

<task type="auto">
  <name>Task 2: Create shs_state.c with init function</name>
  <files>main/shs_state.c</files>
  <read_first>main/shs_state.h (just created), main/shs01.c (lines 44-283 — default values for all globals)</read_first>
  <action>
Create `main/shs_state.c` with:

1. Include `shs_state.h`, `string.h`, `esp_log.h`
2. Static tag: `static const char *TAG = "SHS_STATE";`
3. `shs_state_init(shs_state_t *state)` that:
   - `memset(state, 0, sizeof(*state))` to zero everything first
   - Creates both mutexes:
     ```c
     state->target_data_mutex = xSemaphoreCreateMutex();
     state->zone_config_mutex = xSemaphoreCreateMutex();
     ```
   - Creates save queue:
     ```c
     state->save_q = xQueueCreate(8, sizeof(shs_save_msg_t));
     ```
   - Sets non-zero defaults (from current shs01.c globals):
     ```c
     state->moving_sens_0_100 = 60;
     state->static_sens_0_100 = 50;
     state->moving_max_gate = 8;
     state->static_max_gate = 8;
     state->sens_mv_0_10 = 4;
     state->sens_st_0_10 = 5;
     state->min_moving_energy = 40;
     state->min_static_energy = 40;
     strncpy(state->firmware_version, "Unknown", sizeof(state->firmware_version) - 1);
     ```
   - Sets default zone coordinates for all 5 zones:
     ```c
     for (int i = 0; i < SHS_NUM_ZONES; i++) {
         state->zones[i].x1 = -1500;
         state->zones[i].y1 = 0;
         state->zones[i].x2 = 1500;
         state->zones[i].y2 = 3000;
     }
     ```
   - Logs: `ESP_LOGI(TAG, "State initialized (%d zones)", SHS_NUM_ZONES);`
  </action>
  <acceptance_criteria>
    - main/shs_state.c contains `void shs_state_init(shs_state_t *state)`
    - main/shs_state.c contains `xSemaphoreCreateMutex` twice (target_data_mutex, zone_config_mutex)
    - main/shs_state.c contains `xQueueCreate(8, sizeof(shs_save_msg_t))`
    - main/shs_state.c contains `state->moving_sens_0_100 = 60`
    - main/shs_state.c contains loop setting zone defaults `state->zones[i].x1 = -1500`
  </acceptance_criteria>
  <verify>
    <automated>grep -c "xSemaphoreCreateMutex" main/shs_state.c returns 2</automated>
  </verify>
  <done>shs_state.c compiles, init function creates mutexes, queue, and sets all defaults matching current shs01.c values</done>
</task>

</tasks>

<threat_model>
## Trust Boundaries

No new trust boundaries introduced — this plan only creates internal type definitions and initialization code. No I/O, no external input, no network.

## STRIDE Threat Register

| Threat ID | Category | Component | Disposition | Mitigation Plan |
|---|---|---|---|---|
| T-04-01 | T (Tampering) | shs_state_t fields | accept | Internal struct accessed only by firmware modules — same trust domain |
</threat_model>

<verification>
- Both files compile as part of the ESP-IDF build (CMakeLists auto-discovers .c files in main/)
- `shs_state_t` contains all fields from current shs01.c static globals (verified by count)
- Default values match current shs01.c initializers
</verification>

<success_criteria>
- shs_state.h defines shs_zone_t, shs_zone_cfg_blob_t, shs_state_t, shs_save_evt_t, shs_save_msg_t
- shs_state.c implements shs_state_init() with correct defaults
- Both files compile without errors
</success_criteria>

<output>
After completion, create `.planning/phases/04-code-restructuring/04-01-SUMMARY.md`
</output>
