tigercraft4/SHS-Z2M-Presence/.planning/phases/04-code-restructuring/04-02-PLAN.md

---
phase: 04-code-restructuring
plan: 02
type: execute
wave: 2
depends_on: ["04-01"]
files_modified:
  - main/shs_zigbee.h
  - main/shs_zigbee.c
autonomous: true
requirements:
  - CS-04
  - CC-03
must_haves:
  truths:
    - "All 25 endpoints created in preserved registration order"
    - "Zone occupancy and target count endpoints use loops instead of copy-paste blocks"
    - "Zigbee helpers (set_attr, report_attr, lock macros) accessible from other modules"
  artifacts:
    - path: "main/shs_zigbee.h"
      provides: "Zigbee helper prototypes, lock macros, init prototype"
      contains: "SHS_ZB_LOCK_ACQUIRE_OR_RETURN"
    - path: "main/shs_zigbee.c"
      provides: "Endpoint creation, Zigbee task, BDB commissioning, all ZB helpers"
      contains: "shs_zigbee_task"
  key_links:
    - from: "main/shs_zigbee.c"
      to: "main/shs_state.h"
      via: "shs_state_t pointer for attribute data"
      pattern: "shs_state_t"
---

<objective>
Extract all Zigbee code into shs_zigbee module with endpoint loop factories (CS-04) and preserved registration order (CC-03).

Purpose: Move ~700 lines of endpoint creation, ZB helpers, and Zigbee task out of the monolith. Replace 12+ identical endpoint blocks with helper functions/loops. Preserve exact endpoint registration order for Z2M compatibility.
Output: `main/shs_zigbee.h` (prototypes + macros) and `main/shs_zigbee.c` (implementation)
</objective>

<execution_context>
@~/.copilot/get-shit-done/workflows/execute-plan.md
@~/.copilot/get-shit-done/templates/summary.md
</execution_context>

<context>
@.planning/PROJECT.md
@.planning/ROADMAP.md
@.planning/phases/04-code-restructuring/04-CONTEXT.md
@.planning/phases/04-code-restructuring/04-01-SUMMARY.md
</context>

<tasks>

<task type="auto">
  <name>Task 1: Create shs_zigbee.h with prototypes and lock macros</name>
  <files>main/shs_zigbee.h</files>
  <read_first>main/shs01.c (lines 155-215 — lock macros and ZB helper prototypes), main/shs01.h (cluster/attribute defines), main/shs_state.h (just created — struct definition)</read_first>
  <action>
Create `main/shs_zigbee.h` with:

1. Include guard, includes: `shs_state.h`, `esp_zigbee_core.h`

2. Lock macros (move from shs01.c ~L155-215). These reference the state pointer — redesign to accept state as parameter or use a module-level static pointer. The simplest approach: keep macros referencing a module-static `s_state` pointer set during init. The macros stay identical to current shs01.c:
```c
#define SHS_ZB_LOCK_ACQUIRE_OR_RETURN() \
    do { ... s_state->lock_success_count ... } while(0)
#define SHS_ZB_LOCK_ACQUIRE_OR_RETURN_FALSE() \
    do { ... } while(0)
#define SHS_ZB_LOCK_RELEASE() ...
```
NOTE: Since macros reference module-internal `s_state`, they must be defined in `shs_zigbee.c` NOT the header. The header only exposes function prototypes.

3. Function prototypes:
```c
/* Init — stores state pointer, must be called before any ZB function */
void shs_zigbee_init(shs_state_t *state);

/* Zigbee task entry point (passed to xTaskCreate) */
void shs_zigbee_task(void *pvParameters);

/* Attribute helpers — called by config and sensor modules */
bool shs_zb_set_analog_value(uint8_t endpoint, float value);
bool shs_zb_report_analog_attr(uint8_t endpoint);
bool shs_zb_set_binary_value(uint8_t endpoint, bool value);
bool shs_zb_report_binary_attr(uint8_t endpoint);
bool shs_zb_set_occ_bitmap(uint8_t endpoint, bool occupied);
void shs_zb_set_bool_attr(uint8_t ep, uint16_t cluster, uint16_t attr, bool val);
void shs_zb_set_i16_attr(uint8_t ep, uint16_t cluster, uint16_t attr, int16_t val);
void shs_zb_report_attr(uint8_t ep, uint16_t cluster, uint16_t attr, bool is_mfr);
void shs_zb_set_ou_delay_ep2(uint16_t seconds);

/* Sensor health/diagnostics report (called by sensor module) */
void shs_zb_report_sensor_health(void);
void shs_zb_report_diagnostics(void);
```
  </action>
  <acceptance_criteria>
    - main/shs_zigbee.h exists and contains `void shs_zigbee_init(shs_state_t *state)`
    - main/shs_zigbee.h contains `void shs_zigbee_task(void *pvParameters)`
    - main/shs_zigbee.h contains prototypes for all ZB helper functions: shs_zb_set_analog_value, shs_zb_set_binary_value, shs_zb_set_occ_bitmap, shs_zb_report_attr, shs_zb_report_sensor_health, shs_zb_report_diagnostics
    - main/shs_zigbee.h does NOT contain lock macro definitions (those go in .c file)
  </acceptance_criteria>
  <verify>
    <automated>Select-String "void shs_zb" main/shs_zigbee.h returns at least 8 matches</automated>
  </verify>
  <done>shs_zigbee.h compiles, all Zigbee helper function prototypes declared</done>
</task>

<task type="auto">
  <name>Task 2: Create shs_zigbee.c with endpoint factories and ZB task</name>
  <files>main/shs_zigbee.c</files>
  <read_first>main/shs01.c (lines 155-215 lock macros, 689-970 ZB helpers, 2217-2265 health/diag reports, 2443-2600 BDB/metadata, 2599-3260 zigbee task with all endpoint creation), main/shs_zigbee.h (just created), main/shs_state.h, main/shs01.h</read_first>
  <action>
Create `main/shs_zigbee.c` with all Zigbee code moved from shs01.c:

1. Includes: `shs_zigbee.h`, `shs_state.h`, `shs01.h`, `esp_log.h`, `esp_zigbee_*`, `zcl_utility.h`, `string.h`

2. Module-static state pointer:
```c
static shs_state_t *s_state = NULL;
static const char *TAG = "SHS_ZB";
```

3. `shs_zigbee_init(shs_state_t *state)` — stores state pointer.

4. Lock macros (moved from shs01.c ~L155-215) — keep identical logic but reference `s_state->` instead of direct globals. These stay in the .c file (not header) since they reference `s_state`.

5. All ZB helper functions moved from shs01.c:
   - `shs_zb_set_occ_bitmap` (~L699)
   - `shs_zb_set_bool_attr` (~L712)
   - `shs_zb_report_attr` (~L721)
   - `shs_zb_set_i16_attr` (~L747)
   - `shs_zb_set_ou_delay_ep2` (~L754)
   - `shs_zb_set_analog_value` (~L875)
   - `shs_zb_report_analog_attr` (~L893)
   - `shs_zb_set_binary_value` (~L921)
   - `shs_zb_report_binary_attr` (~L940)
   All functions change from accessing globals directly to using `s_state->` fields.

6. Health/diagnostic reporting functions (moved from ~L2220-2265):
   - `shs_zb_report_sensor_health()` — reports ld2410c/ld2450 connected status
   - `shs_zb_report_diagnostics()` — reports lock/TX counters, uptime, heap

7. BDB commissioning callback (moved from ~L2443), metadata publish (moved from ~L2449).

8. **Endpoint creation with CS-04 factories** — `shs_zigbee_task()`:

   Create two static helper functions:
   ```c
   static void add_binary_ep(esp_zb_ep_list_t *list, uint8_t ep_num,
                             bool *init_val, const zcl_basic_manufacturer_info_t *info)
   ```
   ```c
   static void add_analog_ep(esp_zb_ep_list_t *list, uint8_t ep_num,
                             float init_val, const zcl_basic_manufacturer_info_t *info)
   ```

   Each creates the cluster list, basic cluster, binary/analog input cluster, endpoint config, and calls `esp_zb_ep_list_add_ep` + `esp_zcl_utility_add_ep_basic_manufacturer_info`.

   Endpoint registration in `shs_zigbee_task()` (MUST preserve exact order per D-09):
   - EP1 (Light+Config): Hand-coded (unique — has onoff + custom config cluster with all attributes). Config cluster attribute registration uses a loop for zones:
     ```c
     for (int z = 0; z < SHS_NUM_ZONES; z++) {
         uint16_t base = SHS_ATTR_ZONE1_ENABLED + (z == 0 ? 0 : (z * 0x10 + 0x0F));
         // Zone 1: 0x0021, Zone 2: 0x0030, Zone 3: 0x0040, Zone 4: 0x0050, Zone 5: 0x0060
         // Compute: zone 1 base = 0x0021, zone N base = 0x0020 + N * 0x10
     }
     ```
     Actually the clean formula: `base = (z == 0) ? 0x0021 : (0x0020 + z * 0x10)` for enabled attr. Then offsets +0=enabled, +1=x1, +2=y1, +3=x2, +4=y2, +5=targets, +6=type.
   - EP2 (OCC+Distance): Hand-coded (unique)
   - EP3: `add_binary_ep` with ld2450_occupancy → BUT EP3 uses msOccupancySensing, not genBinaryInput. So EP3 stays hand-coded too.
   - EP4: `add_analog_ep(list, SHS_EP_LD2450_TARGET_COUNT, (float)s_state->ld2450_target_count, &info)`
   - EP5-7: Loop for zones 1-3 occupancy: `add_binary_ep(list, ep, &s_state->zones[i].occupied, &info)` with ep_nums = {5, 6, 7}
   - EP22-23: Loop for zones 4-5 occupancy: `add_binary_ep(list, ep, &s_state->zones[i].occupied, &info)` with ep_nums = {22, 23}
   - EP8-16: Existing loop pattern (target position data) — keep but use s_state
   - EP17: `add_binary_ep(list, SHS_EP_LD2410C_MOVING, &s_state->moving_state, &info)`
   - EP18: `add_binary_ep(list, SHS_EP_LD2410C_STATIC, &s_state->static_state, &info)`
   - EP19-21: Loop for zones 1-3 target count: `add_analog_ep(list, ep, (float)s_state->zones[i].targets, &info)` with ep_nums = {19, 20, 21}
   - EP24-25: Loop for zones 4-5 target count: `add_analog_ep(list, ep, (float)s_state->zones[i].targets, &info)` with ep_nums = {24, 25}

   CRITICAL: Zone occupancy eps and zone target count eps use non-contiguous endpoint numbers (5,6,7,22,23 and 19,20,21,24,25). Use lookup arrays:
   ```c
   static const uint8_t zone_occ_eps[SHS_NUM_ZONES] = {
       SHS_EP_LD2450_ZONE1, SHS_EP_LD2450_ZONE2, SHS_EP_LD2450_ZONE3,
       SHS_EP_LD2450_ZONE4, SHS_EP_LD2450_ZONE5
   };
   static const uint8_t zone_target_eps[SHS_NUM_ZONES] = {
       SHS_EP_ZONE1_TARGETS, SHS_EP_ZONE2_TARGETS, SHS_EP_ZONE3_TARGETS,
       SHS_EP_ZONE4_TARGETS, SHS_EP_ZONE5_TARGETS
   };
   ```

   After all endpoints: `esp_zb_device_register`, `esp_zb_core_action_handler_register`, `esp_zb_set_primary_network_channel_set`, `esp_zb_secur_network_min_join_lqi_set(0)`, `esp_zb_start`, `esp_zb_stack_main_loop`.

   The attribute handler callback (`shs_zb_attribute_handler`) is NOT in this module — it will be in shs_config.c (Plan 03). Register it via `esp_zb_core_action_handler_register` pointing to a function in shs_config that wraps both the light and config attribute handling.
  </action>
  <acceptance_criteria>
    - main/shs_zigbee.c contains `static shs_state_t *s_state`
    - main/shs_zigbee.c contains `static void add_binary_ep(` and `static void add_analog_ep(` helper functions
    - main/shs_zigbee.c contains `zone_occ_eps[SHS_NUM_ZONES]` and `zone_target_eps[SHS_NUM_ZONES]` lookup arrays
    - main/shs_zigbee.c contains the lock macros with `s_state->` references
    - main/shs_zigbee.c contains `shs_zb_report_sensor_health` and `shs_zb_report_diagnostics`
    - main/shs_zigbee.c creates all 25 endpoints in correct order: EP1, EP2, EP3, EP4, EP5-7, EP22-23, EP8-16, EP17-18, EP19-21, EP24-25
  </acceptance_criteria>
  <verify>
    <automated>Select-String "esp_zb_ep_list_add_ep" main/shs_zigbee.c should show endpoint registration calls (some in loops)</automated>
  </verify>
  <done>shs_zigbee.c compiles, all 25 endpoints registered in correct order, zone endpoints use loops instead of copy-paste blocks</done>
</task>

</tasks>

<threat_model>
## Trust Boundaries

| Boundary | Description |
|---|---|
| Zigbee network → firmware | Incoming attribute writes from Z2M coordinator (handled by action handler in config module, not here) |

## STRIDE Threat Register

| Threat ID | Category | Component | Disposition | Mitigation Plan |
|---|---|---|---|---|
| T-04-02 | T (Tampering) | Zigbee attribute writes | mitigate | Attribute handler validates types/ranges before applying (moved to shs_config.c in Plan 03) |
| T-04-03 | D (DoS) | Lock acquisition | mitigate | Lock macros use retry with exponential backoff (preserved from Phase 1 implementation) |
</threat_model>

<verification>
- Endpoint registration order matches current shs01.c exactly (EP1,2,3,4,5,6,7,22,23,8-16,17,18,19,20,21,24,25)
- All ZB helper functions accessible via shs_zigbee.h
- Lock macros use s_state-> instead of direct globals
</verification>

<success_criteria>
- Zone occupancy + target count endpoints use loops with lookup arrays (CS-04)
- Endpoint registration order preserved exactly (CC-03)
- All ZB helpers callable from other modules
</success_criteria>

<output>
After completion, create `.planning/phases/04-code-restructuring/04-02-SUMMARY.md`
</output>
