tigercraft4/SHS-Z2M-Presence/.planning/phases/03-reliability-diagnostics/03-02-PLAN.md

---
phase: 03-reliability-diagnostics
plan: 02
type: execute
wave: 2
depends_on: [03-01]
files_modified:
  - main/shs01.h
  - main/shs01.c
  - zigbee2mqtt/external_converters/shs01_enhanced.js
  - zigbee2mqtt/external_converters/shs01_enhanced.mjs
autonomous: true
requirements: [SH-02, SH-03, ZB-03, ZB-04]

must_haves:
  truths:
    - "LD2410C connected/disconnected status visible in Z2M device page"
    - "LD2450 connected/disconnected status visible in Z2M device page"
    - "LD2450 reconnection updates Zigbee health attributes"
    - "Lock success/fail/consecutive counts visible in Z2M"
    - "TX success/fail counts visible in Z2M"
    - "Uptime and free heap visible in Z2M for remote troubleshooting"
  artifacts:
    - path: "main/shs01.h"
      provides: "Health and diagnostic attribute defines on 0xFDCD"
      contains: "SHS_ATTR_LD2410C_CONNECTED"
    - path: "main/shs01.c"
      provides: "Attribute registration, periodic reporting, reconnection sync"
    - path: "zigbee2mqtt/external_converters/shs01_enhanced.js"
      provides: "fromZigbee decoders for health + diagnostic attributes"
    - path: "zigbee2mqtt/external_converters/shs01_enhanced.mjs"
      provides: "ESM variant of health + diagnostic decoders"
  key_links:
    - from: "shs_ld2450_task reconnection"
      to: "shs_zb_report_health()"
      via: "called when LD2450 reconnects"
      pattern: "shs_zb_report_sensor_health"
    - from: "diagnostic periodic report"
      to: "0xFDCD attributes"
      via: "60s interval in shs_ld2450_task"
      pattern: "shs_zb_report_diagnostics"
    - from: "converter fromZigbee"
      to: "Z2M device page"
      via: "attribute decode"
      pattern: "ld2410c_connected|ld2450_connected|lock_success"
---

<objective>
Expose sensor health status and diagnostic counters via Zigbee attributes on config cluster 0xFDCD, with Z2M converter support.

Purpose: Enable remote troubleshooting — see sensor connectivity, lock contention, and TX reliability from the Z2M device page without serial console access.
Output: 9 new Zigbee attributes (2 health bools + 7 diagnostic counters) + converter decode in both .js and .mjs.
</objective>

<execution_context>
@~/.copilot/get-shit-done/workflows/execute-plan.md
@~/.copilot/get-shit-done/templates/summary.md
</execution_context>

<context>
@.planning/PROJECT.md
@.planning/ROADMAP.md
@.planning/STATE.md
@.planning/phases/03-reliability-diagnostics/03-CONTEXT.md
@.planning/phases/03-reliability-diagnostics/03-01-SUMMARY.md
</context>

<interfaces>
<!-- Key types and contracts the executor needs from Plan 01 output -->

From main/shs01.c (added by Plan 01):
```c
/* LD2410C health monitoring */
static uint32_t shs_ld2410c_last_frame_ms = 0;
static bool shs_ld2410c_connected = false;
#define SHS_LD2410C_FRAME_TIMEOUT_MS  3000

/* Existing LD2450 connectivity */
static bool shs_ld2450_connected = false;  /* set true on first LD2450 callback */

/* Existing diagnostic counters */
static uint32_t shs_lock_success_count = 0;
static uint32_t shs_lock_fail_count = 0;
static uint32_t shs_lock_consecutive_fails = 0;
static uint32_t shs_tx_success_count = 0;
static uint32_t shs_tx_fail_count = 0;
```

From main/shs01.h (existing patterns):
```c
/* Config cluster on EP1 */
#define SHS_CL_CFG_ID  0xFDCD

/* Attribute ID layout:
   0x0001-0x000A: general config
   0x0020-0x0066: zone config (5 zones, 0x10 stride)
   0x0070+: AVAILABLE for health/diagnostics */
```

From zigbee2mqtt/external_converters/shs01_enhanced.js (existing patterns):
```js
const CLUSTER_CONFIG = 0xFDCD;
// Pattern: define ATTR_* constants, add fromZigbee converter, add expose
```
</interfaces>

<tasks>

<task type="auto">
  <name>Task 1: Health + diagnostic attributes in firmware</name>
  <files>main/shs01.h, main/shs01.c</files>
  <read_first>
    - main/shs01.h (full file — attribute layout, find available IDs after 0x0066)
    - main/shs01.c §L120-150 (existing diagnostic counters and flags)
    - main/shs01.c §L2240-2260 (LD2450 reconnection logic — was_connected transition)
    - main/shs01.c §L2265-2310 (Zigbee connectivity check + heartbeat + rejoin)
    - main/shs01.c — search for `esp_zb_cluster_add_attr` or `esp_zb_custom_cluster_add_custom_attr` pattern to understand attribute registration
    - main/shs01.c — search for `shs_zb_set_analog_value` pattern for reporting
  </read_first>
  <action>
**main/shs01.h** — Add health and diagnostic attribute defines after `SHS_ATTR_ZONE5_TYPE_CFG` (0x0066). Use 0x0070+ range on config cluster 0xFDCD EP1 (per D-05, D-12 choosing config cluster for consistency):

```c
/* ============================================================================
 * HEALTH & DIAGNOSTICS ATTRIBUTES (0xFDCD on EP1)
 * ============================================================================ */

/* Sensor health (per D-05, D-06, D-07) */
#define SHS_ATTR_LD2410C_CONNECTED      0x0070  /* bool, read-only */
#define SHS_ATTR_LD2450_CONNECTED       0x0071  /* bool, read-only */

/* Diagnostic counters (per D-12, D-13 — 5 existing + uptime + free heap) */
#define SHS_ATTR_DIAG_LOCK_SUCCESS      0x0080  /* uint32, read-only */
#define SHS_ATTR_DIAG_LOCK_FAIL         0x0081  /* uint32, read-only */
#define SHS_ATTR_DIAG_LOCK_CONSEC_FAIL  0x0082  /* uint32, read-only */
#define SHS_ATTR_DIAG_TX_SUCCESS        0x0083  /* uint32, read-only */
#define SHS_ATTR_DIAG_TX_FAIL           0x0084  /* uint32, read-only */
#define SHS_ATTR_DIAG_UPTIME_S          0x0085  /* uint32, read-only, seconds since boot */
#define SHS_ATTR_DIAG_FREE_HEAP         0x0086  /* uint32, read-only, bytes */
```

**main/shs01.c** — Register the 9 new attributes on the config cluster (0xFDCD, EP1). Find the existing config cluster attribute registration code (look for where `SHS_ATTR_MOVEMENT_COOLDOWN` or `SHS_ATTR_POSITION_REPORTING` are registered on the cluster). Add the new attributes using the same registration pattern:
- `SHS_ATTR_LD2410C_CONNECTED`: type bool, access read-only, default false
- `SHS_ATTR_LD2450_CONNECTED`: type bool, access read-only, default false
- `SHS_ATTR_DIAG_LOCK_SUCCESS` through `SHS_ATTR_DIAG_FREE_HEAP`: type uint32, access read-only, default 0

**main/shs01.c** — Add health reporting function:
```c
/* Report sensor health status via Zigbee (per D-05) */
static void shs_zb_report_sensor_health(void) {
    SHS_ZB_LOCK_ACQUIRE_OR_RETURN();

    bool ld2410c = shs_ld2410c_connected;
    bool ld2450 = shs_ld2450_connected;

    esp_zb_zcl_set_attribute_val(SHS_EP_LIGHT, SHS_CL_CFG_ID,
        ESP_ZB_ZCL_CLUSTER_SERVER_ROLE, SHS_ATTR_LD2410C_CONNECTED,
        &ld2410c, false);
    esp_zb_zcl_set_attribute_val(SHS_EP_LIGHT, SHS_CL_CFG_ID,
        ESP_ZB_ZCL_CLUSTER_SERVER_ROLE, SHS_ATTR_LD2450_CONNECTED,
        &ld2450, false);

    esp_zb_lock_release();
}
```

**main/shs01.c** — Add diagnostic reporting function (per D-13 — all 5 counters + uptime + heap):
```c
/* Report diagnostic counters via Zigbee (per D-12, D-13) */
static void shs_zb_report_diagnostics(void) {
    SHS_ZB_LOCK_ACQUIRE_OR_RETURN();

    uint32_t uptime = (uint32_t)(esp_timer_get_time() / 1000000);
    uint32_t heap = (uint32_t)esp_get_free_heap_size();

    esp_zb_zcl_set_attribute_val(SHS_EP_LIGHT, SHS_CL_CFG_ID,
        ESP_ZB_ZCL_CLUSTER_SERVER_ROLE, SHS_ATTR_DIAG_LOCK_SUCCESS,
        &shs_lock_success_count, false);
    esp_zb_zcl_set_attribute_val(SHS_EP_LIGHT, SHS_CL_CFG_ID,
        ESP_ZB_ZCL_CLUSTER_SERVER_ROLE, SHS_ATTR_DIAG_LOCK_FAIL,
        &shs_lock_fail_count, false);
    esp_zb_zcl_set_attribute_val(SHS_EP_LIGHT, SHS_CL_CFG_ID,
        ESP_ZB_ZCL_CLUSTER_SERVER_ROLE, SHS_ATTR_DIAG_LOCK_CONSEC_FAIL,
        &shs_lock_consecutive_fails, false);
    esp_zb_zcl_set_attribute_val(SHS_EP_LIGHT, SHS_CL_CFG_ID,
        ESP_ZB_ZCL_CLUSTER_SERVER_ROLE, SHS_ATTR_DIAG_TX_SUCCESS,
        &shs_tx_success_count, false);
    esp_zb_zcl_set_attribute_val(SHS_EP_LIGHT, SHS_CL_CFG_ID,
        ESP_ZB_ZCL_CLUSTER_SERVER_ROLE, SHS_ATTR_DIAG_TX_FAIL,
        &shs_tx_fail_count, false);
    esp_zb_zcl_set_attribute_val(SHS_EP_LIGHT, SHS_CL_CFG_ID,
        ESP_ZB_ZCL_CLUSTER_SERVER_ROLE, SHS_ATTR_DIAG_UPTIME_S,
        &uptime, false);
    esp_zb_zcl_set_attribute_val(SHS_EP_LIGHT, SHS_CL_CFG_ID,
        ESP_ZB_ZCL_CLUSTER_SERVER_ROLE, SHS_ATTR_DIAG_FREE_HEAP,
        &heap, false);

    esp_zb_lock_release();
}
```

**main/shs01.c** — LD2450 reconnection Zigbee sync (per D-08, choosing health attr report on reconnect):
In `shs_ld2450_task()`, find the `if (!was_connected)` block (LD2450 first connection / reconnection). After the existing `ld2450_read_firmware_version()` call, add:
```c
/* Report updated sensor health on reconnection (per D-08) */
if (shs_zb_ready) {
    shs_zb_report_sensor_health();
}
```
Also add health report when LD2450 disconnects — in the `else if (was_connected)` block:
```c
/* Report disconnection (per D-08) */
if (shs_zb_ready) {
    shs_zb_report_sensor_health();
}
```

**main/shs01.c** — Periodic diagnostic + health reporting (per D-14 refinement):
In the existing 60-second Zigbee connectivity check block in `shs_ld2450_task()` (where diagnostic stats are already logged), after the `ESP_LOGI` log line, add:
```c
/* Report health and diagnostics to Z2M (every 60s) */
shs_zb_report_sensor_health();
shs_zb_report_diagnostics();
```

**main/shs01.c** — ZB-04 connectivity recovery refinement (per D-14):
The existing connectivity check (180s TX timeout → rejoin) is adequate. Add: after the `shs_zb_rejoin_pending = true;` line, update health attributes to reflect disconnected state:
```c
/* Update health attrs to reflect connectivity loss */
shs_zb_report_sensor_health();
```
  </action>
  <verify>
    <automated>grep -c "SHS_ATTR_LD2410C_CONNECTED\|SHS_ATTR_LD2450_CONNECTED\|SHS_ATTR_DIAG_LOCK_SUCCESS\|shs_zb_report_sensor_health\|shs_zb_report_diagnostics" main/shs01.c main/shs01.h</automated>
  </verify>
  <acceptance_criteria>
    - shs01.h contains `SHS_ATTR_LD2410C_CONNECTED  0x0070`
    - shs01.h contains `SHS_ATTR_LD2450_CONNECTED   0x0071`
    - shs01.h contains `SHS_ATTR_DIAG_LOCK_SUCCESS   0x0080` through `SHS_ATTR_DIAG_FREE_HEAP 0x0086`
    - shs01.c contains `shs_zb_report_sensor_health` function definition
    - shs01.c contains `shs_zb_report_diagnostics` function definition
    - shs01.c calls `shs_zb_report_sensor_health()` in LD2450 reconnect/disconnect transitions
    - shs01.c calls `shs_zb_report_diagnostics()` in the 60s periodic check block
    - 9 new attributes registered on config cluster 0xFDCD EP1
    - `idf.py build` compiles without errors
  </acceptance_criteria>
  <done>9 Zigbee attributes registered on 0xFDCD: 2 sensor health bools + 7 diagnostic uint32s. Health reported on connect/disconnect events + every 60s. Diagnostics reported every 60s.</done>
</task>

<task type="auto">
  <name>Task 2: Z2M converter — health + diagnostic attributes</name>
  <files>zigbee2mqtt/external_converters/shs01_enhanced.js, zigbee2mqtt/external_converters/shs01_enhanced.mjs</files>
  <read_first>
    - zigbee2mqtt/external_converters/shs01_enhanced.js §L59-100 (existing config cluster constants and attribute definitions)
    - zigbee2mqtt/external_converters/shs01_enhanced.js — search for `fromZigbee` config cluster handler (pattern for reading 0xFDCD attributes)
    - zigbee2mqtt/external_converters/shs01_enhanced.js — search for `exposes` section to understand expose pattern
    - zigbee2mqtt/external_converters/shs01_enhanced.mjs §L59-100 (same for ESM variant)
  </read_first>
  <action>
**Both .js and .mjs** — Apply identical changes to both files.

**Add attribute constants** after the existing zone config attribute constants (after `ATTR_ZONE5_TYPE_CFG` or similar):
```js
// Health attributes (on Config cluster 0xFDCD)
const ATTR_LD2410C_CONNECTED = 0x0070;
const ATTR_LD2450_CONNECTED = 0x0071;

// Diagnostic attributes (on Config cluster 0xFDCD)
const ATTR_DIAG_LOCK_SUCCESS = 0x0080;
const ATTR_DIAG_LOCK_FAIL = 0x0081;
const ATTR_DIAG_LOCK_CONSEC_FAIL = 0x0082;
const ATTR_DIAG_TX_SUCCESS = 0x0083;
const ATTR_DIAG_TX_FAIL = 0x0084;
const ATTR_DIAG_UPTIME = 0x0085;
const ATTR_DIAG_FREE_HEAP = 0x0086;
```

**Add fromZigbee handler** — find the existing fromZigbee handler that processes 0xFDCD cluster attributes (the one that handles zone config, sensitivity, etc.). In its `convert` function, add cases for the new attribute IDs:
```js
// Health status
if (msg.data.hasOwnProperty(ATTR_LD2410C_CONNECTED)) {
    result.ld2410c_connected = msg.data[ATTR_LD2410C_CONNECTED] ? true : false;
}
if (msg.data.hasOwnProperty(ATTR_LD2450_CONNECTED)) {
    result.ld2450_connected = msg.data[ATTR_LD2450_CONNECTED] ? true : false;
}
// Diagnostic counters
if (msg.data.hasOwnProperty(ATTR_DIAG_LOCK_SUCCESS)) {
    result.diag_lock_success = msg.data[ATTR_DIAG_LOCK_SUCCESS];
}
if (msg.data.hasOwnProperty(ATTR_DIAG_LOCK_FAIL)) {
    result.diag_lock_fail = msg.data[ATTR_DIAG_LOCK_FAIL];
}
if (msg.data.hasOwnProperty(ATTR_DIAG_LOCK_CONSEC_FAIL)) {
    result.diag_lock_consecutive_fails = msg.data[ATTR_DIAG_LOCK_CONSEC_FAIL];
}
if (msg.data.hasOwnProperty(ATTR_DIAG_TX_SUCCESS)) {
    result.diag_tx_success = msg.data[ATTR_DIAG_TX_SUCCESS];
}
if (msg.data.hasOwnProperty(ATTR_DIAG_TX_FAIL)) {
    result.diag_tx_fail = msg.data[ATTR_DIAG_TX_FAIL];
}
if (msg.data.hasOwnProperty(ATTR_DIAG_UPTIME)) {
    result.diag_uptime_seconds = msg.data[ATTR_DIAG_UPTIME];
}
if (msg.data.hasOwnProperty(ATTR_DIAG_FREE_HEAP)) {
    result.diag_free_heap = msg.data[ATTR_DIAG_FREE_HEAP];
}
```

**Add exposes** — in the `exposes` array of the device definition, add:
```js
// Health
e.binary('ld2410c_connected', ea.STATE, true, false)
    .withDescription('LD2410C sensor connected'),
e.binary('ld2450_connected', ea.STATE, true, false)
    .withDescription('LD2450 sensor connected'),
// Diagnostics
e.numeric('diag_lock_success', ea.STATE)
    .withDescription('Zigbee lock acquisition successes'),
e.numeric('diag_lock_fail', ea.STATE)
    .withDescription('Zigbee lock acquisition failures'),
e.numeric('diag_lock_consecutive_fails', ea.STATE)
    .withDescription('Consecutive Zigbee lock failures'),
e.numeric('diag_tx_success', ea.STATE)
    .withDescription('Zigbee TX successes'),
e.numeric('diag_tx_fail', ea.STATE)
    .withDescription('Zigbee TX failures'),
e.numeric('diag_uptime_seconds', ea.STATE)
    .withUnit('s').withDescription('Device uptime in seconds'),
e.numeric('diag_free_heap', ea.STATE)
    .withUnit('bytes').withDescription('Free heap memory'),
```

**Add attribute IDs to configure reporting** — in the `configure` function, find where config cluster attributes are read/bound. Add the health attribute IDs to the read list so Z2M fetches initial values on interview:
```js
// Read health + diagnostic attributes
await endpoint.read(CLUSTER_CONFIG, [
    ATTR_LD2410C_CONNECTED, ATTR_LD2450_CONNECTED,
    ATTR_DIAG_LOCK_SUCCESS, ATTR_DIAG_LOCK_FAIL, ATTR_DIAG_LOCK_CONSEC_FAIL,
    ATTR_DIAG_TX_SUCCESS, ATTR_DIAG_TX_FAIL, ATTR_DIAG_UPTIME, ATTR_DIAG_FREE_HEAP,
]);
```
  </action>
  <verify>
    <automated>grep -c "ld2410c_connected\|ld2450_connected\|diag_lock_success\|diag_uptime" zigbee2mqtt/external_converters/shs01_enhanced.js zigbee2mqtt/external_converters/shs01_enhanced.mjs</automated>
  </verify>
  <acceptance_criteria>
    - shs01_enhanced.js contains `ATTR_LD2410C_CONNECTED = 0x0070`
    - shs01_enhanced.js contains `ATTR_DIAG_LOCK_SUCCESS = 0x0080`
    - shs01_enhanced.js contains `result.ld2410c_connected` in fromZigbee handler
    - shs01_enhanced.js contains `e.binary('ld2410c_connected'` in exposes
    - shs01_enhanced.js contains `e.numeric('diag_uptime_seconds'` in exposes
    - shs01_enhanced.mjs contains identical attribute constants and converter logic
    - Both files contain all 9 new attribute constants (2 health + 7 diagnostic)
  </acceptance_criteria>
  <done>Both Z2M converters (.js + .mjs) decode all 9 health/diagnostic attributes. Sensor connectivity and lock/TX stats visible in Z2M device page.</done>
</task>

</tasks>

<threat_model>
## Trust Boundaries

| Boundary | Description |
|---|---|
| firmware → Z2M converter | Attribute values cross Zigbee network — converter trusts firmware data |
| Z2M → user | Diagnostic counters are informational — no control path |

## STRIDE Threat Register

| Threat ID | Category | Component | Disposition | Mitigation Plan |
|---|---|---|---|---|
| T-03-04 | I (Information Disclosure) | Diagnostic counters | accept | Counters are non-sensitive operational metrics (uptime, heap, lock stats). No PII or secrets. Zigbee network is local/trusted. |
| T-03-05 | S (Spoofing) | Health status attrs | accept | Read-only attributes set by firmware only. No external write path. Z2M converter reads but cannot modify. |
</threat_model>

<verification>
- `grep "SHS_ATTR_LD2410C_CONNECTED\|SHS_ATTR_LD2450_CONNECTED" main/shs01.h` returns 2 defines
- `grep "SHS_ATTR_DIAG_" main/shs01.h` returns 7 defines (0x0080-0x0086)
- `grep "shs_zb_report_sensor_health\|shs_zb_report_diagnostics" main/shs01.c` returns function defs + call sites
- `grep "ld2410c_connected" zigbee2mqtt/external_converters/shs01_enhanced.js` returns attribute const + fromZigbee + expose
- `grep "ld2410c_connected" zigbee2mqtt/external_converters/shs01_enhanced.mjs` returns same
- `idf.py build` compiles without errors
</verification>

<success_criteria>
- Z2M device page shows `ld2410c_connected` and `ld2450_connected` booleans
- Z2M device page shows 7 diagnostic counters (lock success/fail/consecutive, TX success/fail, uptime, free heap)
- Health attributes update within 60s of sensor connect/disconnect events
- Diagnostic counters update every 60s
- LD2450 reconnection triggers immediate health attribute update
- Existing Z2M pairing preserved (no new endpoints, same cluster 0xFDCD on EP1)
</success_criteria>

<output>
After completion, create `.planning/phases/03-reliability-diagnostics/03-02-SUMMARY.md`
</output>
