tigercraft4/SHS-Z2M-Presence/.planning/phases/02-sensor-filters/02-01-PLAN.md

---
phase: 02-sensor-filters
plan: 01
type: execute
wave: 1
depends_on: []
files_modified:
  - main/shs01.c
autonomous: true
requirements:
  - SF-01
  - SF-02
  - SF-03
  - CC-01

must_haves:
  truths:
    - "EMA smoothing active at α=0.3 — position updates are smooth, not jittery"
    - "LD2410C reports valid presence when LD2450 is disconnected (standalone mode)"
    - "Position updates rate-limited — no more than one Zigbee report per 200ms"
    - "X coordinates transmitted as int16 without +3000 bias — raw signed values on the wire"
  artifacts:
    - path: "main/shs01.c"
      provides: "Smoothing, standalone filter, rate limiting, int16 encoding"
      contains: "EMA_ALPHA.*0.3f"
  key_links:
    - from: "main/shs01.c (shs_on_ld2450_target_update)"
      to: "Zigbee attribute reports"
      via: "shs_zb_set_i16_attr instead of shs_zb_set_analog_value for position"
      pattern: "shs_zb_set_i16_attr"
    - from: "main/shs01.c (shs_on_state_change)"
      to: "LD2410C occupancy reporting"
      via: "standalone filter when ld2450_count check uses connectivity flag"
      pattern: "ld2450_connected"
---

<objective>
Re-enable position smoothing, add LD2410C standalone filtering, and switch position coordinates from float+bias to proper int16 encoding.

Purpose: Position data is currently raw (jittery), LD2410C is useless when LD2450 is offline, and the +3000 coordinate bias is a hack that wastes bandwidth and causes confusion.
Output: Clean position data, standalone LD2410C operation, proper int16 coordinate encoding in firmware.
</objective>

<execution_context>
@~/.copilot/get-shit-done/workflows/execute-plan.md
@~/.copilot/get-shit-done/templates/summary.md
</execution_context>

<context>
@.planning/PROJECT.md
@.planning/ROADMAP.md
@.planning/STATE.md
@.planning/phases/01-critical-bug-fixes/01-01-SUMMARY.md
@main/shs01.c
@main/shs01.h

<interfaces>
<!-- Key functions and macros the executor needs -->

From main/shs01.c:
```c
// Position smoothing (line ~270) — currently disabled:
#define EMA_ALPHA                    1.0f  /* DIAGNOSTIC: Disabled for raw data testing */
#define POSITION_UPDATE_INTERVAL_MS  300   /* Minimum ms between Zigbee updates */
#define POSITION_CHANGE_THRESHOLD    30    /* Minimum mm change to trigger update */

static float smoothed_x[3] = {0, 0, 0};
static float smoothed_y[3] = {0, 0, 0};

// Int16 attribute setter (line ~701) — defined but unused:
__attribute__((unused)) static void shs_zb_set_i16_attr(uint8_t endpoint, uint16_t cluster, uint16_t attr_id, int16_t value) {
    if (!shs_zb_ready) return;
    SHS_ZB_LOCK_ACQUIRE_OR_RETURN();
    esp_zb_zcl_set_attribute_val(endpoint, cluster, ESP_ZB_ZCL_CLUSTER_SERVER_ROLE, attr_id, &value, true);
    esp_zb_lock_release();
}

// Analog value setter (line ~845) — currently used for position:
static bool shs_zb_set_analog_value(uint8_t endpoint, float value) { ... }

// LD2410C state callback (line ~723) — cross-validation gate:
// if (ld2450_count == 0) { raw_moving = false; raw_static = false; }

// LD2410C error filter (inside shs_on_state_change, line ~735, wrapped in #if 0):
// Gate 0 hard block and minimum energy filter — currently disabled
```

From main/shs01.h:
```c
// Position data endpoints use genAnalogInput (SHS_CLUSTER_ANALOG_INPUT = 0x000C)
#define SHS_EP_LD2450_T1_X              8
#define SHS_EP_LD2450_T1_Y              9
#define SHS_EP_LD2450_T1_DIST           10
// ... T2 (11-13), T3 (14-16)
```
</interfaces>
</context>

<tasks>

<task type="auto">
  <name>Task 1: Re-enable EMA smoothing and adjust rate limiting</name>
  <files>main/shs01.c</files>
  <read_first>main/shs01.c (lines 264-280 for smoothing defines, lines 1060-1160 for position update logic)</read_first>
  <action>
1. Change `EMA_ALPHA` from `1.0f` to `0.3f` and update the comment:
   - Old: `#define EMA_ALPHA                    1.0f  /* DIAGNOSTIC: Disabled for raw data testing */`
   - New: `#define EMA_ALPHA                    0.3f  /* EMA smoothing: 0.1=very smooth, 0.9=responsive */`

2. Change `POSITION_UPDATE_INTERVAL_MS` from `300` to `200`:
   - Old: `#define POSITION_UPDATE_INTERVAL_MS  300   /* Minimum ms between Zigbee updates */`
   - New: `#define POSITION_UPDATE_INTERVAL_MS  200   /* Minimum ms between Zigbee updates */`

No other code changes needed — the EMA smoothing logic in `shs_on_ld2450_target_update()` already uses `EMA_ALPHA` correctly with proper initialization and reset on target inactive.
  </action>
  <verify>
    <automated>grep -n "EMA_ALPHA.*0.3f" main/shs01.c && grep -n "POSITION_UPDATE_INTERVAL_MS.*200" main/shs01.c</automated>
  </verify>
  <acceptance_criteria>
    - `main/shs01.c` contains `#define EMA_ALPHA                    0.3f`
    - `main/shs01.c` contains `#define POSITION_UPDATE_INTERVAL_MS  200`
    - No `DIAGNOSTIC` or `Disabled` text remains in the EMA_ALPHA comment
    - Smoothing math unchanged: `smoothed_x[i] = EMA_ALPHA * raw_x + (1.0f - EMA_ALPHA) * smoothed_x[i]`
  </acceptance_criteria>
  <done>EMA smoothing active at α=0.3, position updates rate-limited to 200ms minimum interval</done>
</task>

<task type="auto">
  <name>Task 2: Enable LD2410C standalone error filtering</name>
  <files>main/shs01.c</files>
  <read_first>main/shs01.c (lines 723-830 for shs_on_state_change function, lines 95-120 for state variables)</read_first>
  <action>
In `shs_on_state_change()`, the LD2450 cross-validation currently forces both `raw_moving` and `raw_static` to false when `ld2450_count == 0`. This means if the LD2450 sensor is disconnected or fails, the LD2410C is completely silenced — no occupancy reported at all.

**SF-02 fix:** Add a `static bool shs_ld2450_connected` flag that tracks whether LD2450 has ever reported data. When LD2450 is disconnected, fall through to the `#if 0` energy filter block instead of blanking all LD2410C detections.

1. Add a new static variable near the other state variables (around line 95):
   ```c
   static bool shs_ld2450_connected = false;  /* Set true on first LD2450 target callback */
   ```

2. At the top of `shs_on_ld2450_target_update()` (line ~1003), add:
   ```c
   shs_ld2450_connected = true;
   ```

3. In `shs_on_state_change()`, replace the unconditional cross-validation block:
   ```c
   /* OLD — unconditional silence when LD2450 sees 0: */
   if (ld2450_count == 0) {
       raw_moving = false;
       raw_static = false;
   }
   ```
   With a conditional that only applies cross-validation when LD2450 is actually connected:
   ```c
   if (shs_ld2450_connected && ld2450_count == 0) {
       /* LD2450 is connected but sees 0 targets — LD2410C detections are likely interference */
       raw_moving = false;
       raw_static = false;
   } else if (!shs_ld2450_connected) {
       /* LD2450 offline — use LD2410C standalone with energy filters as fallback */
       if (raw_moving && state->target.moving_energy < shs_min_moving_energy) {
           raw_moving = false;
       }
       if (raw_static && state->target.static_energy < shs_min_static_energy) {
           raw_static = false;
       }
   }
   ```

4. Remove the `#if 0` / `#endif` block around the old gate 0 and energy filter code (lines ~735-756). The energy filter logic is now incorporated into the standalone fallback above. The gate 0 filter is NOT re-enabled (LD2450 cross-validation handles near-field noise when connected).
  </action>
  <verify>
    <automated>grep -n "shs_ld2450_connected" main/shs01.c | head -10 && grep -c "#if 0" main/shs01.c</automated>
  </verify>
  <acceptance_criteria>
    - `main/shs01.c` contains `static bool shs_ld2450_connected = false;`
    - `shs_ld2450_connected = true;` appears inside `shs_on_ld2450_target_update()`
    - Cross-validation block checks `shs_ld2450_connected &&` before zeroing LD2410C
    - Standalone filter uses `shs_min_moving_energy` and `shs_min_static_energy` thresholds
    - The `#if 0` block around the old energy filter is removed (count of `#if 0` in file decreases by 1)
  </acceptance_criteria>
  <done>LD2410C reports valid presence when LD2450 is offline, using energy filter as standalone fallback</done>
</task>

<task type="auto">
  <name>Task 3: Switch position coordinates from float+bias to int16 encoding</name>
  <files>main/shs01.c</files>
  <read_first>main/shs01.c (lines 700-710 for shs_zb_set_i16_attr, lines 845-895 for shs_zb_set_analog_value and shs_zb_report_analog_attr, lines 1090-1160 for position reporting section)</read_first>
  <action>
**CC-01:** Replace the float+bias coordinate reporting with direct int16 attribute writes. The `shs_zb_set_i16_attr()` function already exists (line ~701) but is unused.

1. Remove the `__attribute__((unused))` from `shs_zb_set_i16_attr` declaration.

2. Create a new report function for int16 attributes. Add after `shs_zb_report_analog_attr()` (~line 895):
   ```c
   /* Report a manufacturer-specific int16 attribute on the target cluster */
   static bool shs_zb_report_i16_attr(uint8_t endpoint, uint16_t cluster, uint16_t attr_id) {
       if (!shs_zb_ready) return false;
       esp_zb_zcl_report_attr_cmd_t cmd = {
           .zcl_basic_cmd = {
               .src_endpoint = endpoint,
               .dst_endpoint = 1,
               .dst_addr_u.addr_short = 0x0000,
           },
           .address_mode = ESP_ZB_APS_ADDR_MODE_16_ENDP_PRESENT,
           .clusterID = cluster,
           .direction = ESP_ZB_ZCL_CMD_DIRECTION_TO_CLI,
           .dis_default_resp = 1,
           .manuf_specific = 0,
           .manuf_code = 0,
           .attributeID = attr_id,
       };
       SHS_ZB_LOCK_ACQUIRE_OR_RETURN_FALSE();
       esp_zb_zcl_report_attr_cmd_req(&cmd);
       shs_last_successful_tx = (uint32_t)(esp_timer_get_time() / 1000);
       shs_tx_success_count++;
       esp_zb_lock_release();
       return true;
   }
   ```

3. In the position reporting section of `shs_on_ld2450_target_update()` (~lines 1095-1150), replace the float+bias coordinate writes. The existing code does:
   ```c
   float x_biased = (float)(new_x + 3000);
   shs_zb_set_analog_value(ep_base, x_biased);       // X with bias
   shs_zb_set_analog_value(ep_base + 1, (float)new_y); // Y
   shs_zb_set_analog_value(ep_base + 2, (float)new_dist); // Distance
   shs_zb_report_analog_attr(ep_base);
   shs_zb_report_analog_attr(ep_base + 1);
   shs_zb_report_analog_attr(ep_base + 2);
   ```

   Replace with direct int16 writes using the target cluster on EP3 (0xFDCF):
   ```c
   /* Target data cluster on EP3 */
   #define SHS_CL_TARGET_ID 0xFDCF
   ```
   Wait — the current approach uses genAnalogInput (presentValue) on separate endpoints (EP8-16). Changing to a custom cluster would break existing Z2M converter parsing.

   **Better approach:** Keep the same endpoint structure (EP8-16 with genAnalogInput) but send int16 values through `presentValue` without the +3000 bias. The presentValue attribute (0x0055) on genAnalogInput is typed as float in the cluster definition, but the Z2M converter reads `msg.data.presentValue` which handles numeric values.

   Actually, the cleanest fix is simpler: just remove the +3000 bias and send the raw coordinate as float. The converter then stops subtracting 3000.

   Replace the position data sending block (~lines 1112-1130):
   ```c
   /* Send X coordinate directly (no bias) */
   shs_zb_set_analog_value(ep_base, (float)new_x);
   shs_zb_report_analog_attr(ep_base);

   /* Send Y coordinate */
   shs_zb_set_analog_value(ep_base + 1, (float)new_y);
   shs_zb_report_analog_attr(ep_base + 1);

   /* Send Distance */
   shs_zb_set_analog_value(ep_base + 2, (float)new_dist);
   shs_zb_report_analog_attr(ep_base + 2);
   ```
   Remove the `float x_biased = (float)(new_x + 3000);` line and the log that references `biased`.
   Update the log to: `ESP_LOGI(SHS_TAG, "ZB T%d: X=%d Y=%d D=%d", i+1, new_x, new_y, new_dist);`

4. For the target-inactive zero-send block (~lines 1137-1141), change:
   ```c
   shs_zb_set_analog_value(ep_base, 3000.0f);  /* 3000 - 3000 = 0 in Z2M */
   ```
   To:
   ```c
   shs_zb_set_analog_value(ep_base, 0.0f);  /* No bias needed */
   ```
   Remove the comment about `3000 - 3000 = 0 in Z2M`.
  </action>
  <verify>
    <automated>grep -n "3000" main/shs01.c | grep -i "bias\|workaround\|subtract" | head -5; echo "---"; grep -c "x_biased" main/shs01.c</automated>
  </verify>
  <acceptance_criteria>
    - No `+ 3000` bias addition in position reporting code
    - No `x_biased` variable anywhere in the file
    - No `3000.0f` in the zero-send block for inactive targets
    - `shs_zb_set_analog_value(ep_base, (float)new_x)` present (direct X without bias)
    - Log message shows `"ZB T%d: X=%d Y=%d D=%d"` without "biased"
    - `__attribute__((unused))` removed from `shs_zb_set_i16_attr`
  </acceptance_criteria>
  <done>Coordinates sent as raw signed values without +3000 bias hack</done>
</task>

</tasks>

<threat_model>
## Trust Boundaries

| Boundary | Description |
|---|---|
| Sensor UART → firmware | LD2410C/LD2450 data is trusted (local hardware) |
| Firmware → Zigbee stack | Attribute values set locally, no untrusted input |
| Zigbee → Z2M converter | Data over Zigbee network, parsed by converter |

## STRIDE Threat Register

| Threat ID | Category | Component | Disposition | Mitigation Plan |
|---|---|---|---|---|
| T-02-01 | T (Tampering) | EMA smoothing | accept | Local sensor data, no external input — smoothing cannot be tampered |
| T-02-02 | D (Denial of Service) | Rate limiting | mitigate | POSITION_UPDATE_INTERVAL_MS=200 prevents Zigbee flooding; existing threshold check prevents no-change reports |
| T-02-03 | I (Info Disclosure) | int16 encoding | accept | Position data is intentionally exposed via Zigbee for Z2M; removing bias doesn't change exposure |
</threat_model>

<verification>
- `grep -n "EMA_ALPHA.*0.3f" main/shs01.c` returns the define
- `grep -n "shs_ld2450_connected" main/shs01.c` returns declaration + usage
- `grep -c "x_biased" main/shs01.c` returns 0
- `grep -c "3000" main/shs01.c` shows reduced count (zone defaults like `3000` in zone coords are OK)
- No compiler errors: `idf.py build` succeeds (if build environment available)
</verification>

<success_criteria>
- EMA smoothing active (α=0.3), rate limit at 200ms
- LD2410C standalone filtering works when LD2450 disconnected
- No +3000 coordinate bias in position reporting
- All existing occupancy logic preserved (zones, target counts, cross-validation when connected)
</success_criteria>

<output>
After completion, create `.planning/phases/02-sensor-filters/02-01-SUMMARY.md`
</output>
