tigercraft4/SHS-Z2M-Presence/hardware/v1/BOM_JLCPCB.csv

Comment | Designator | Footprint | LCSC Part #
100nF | C1 C2 | C_0805_2012Metric | C28233
10uF | C3 | C_0805_2012Metric | C15850
