tigercraft4/SHS-Z2M-Presence/hardware/v2/CONN-SMD_ESP32-C61-WROOM-1U_2026-04-30.dxf

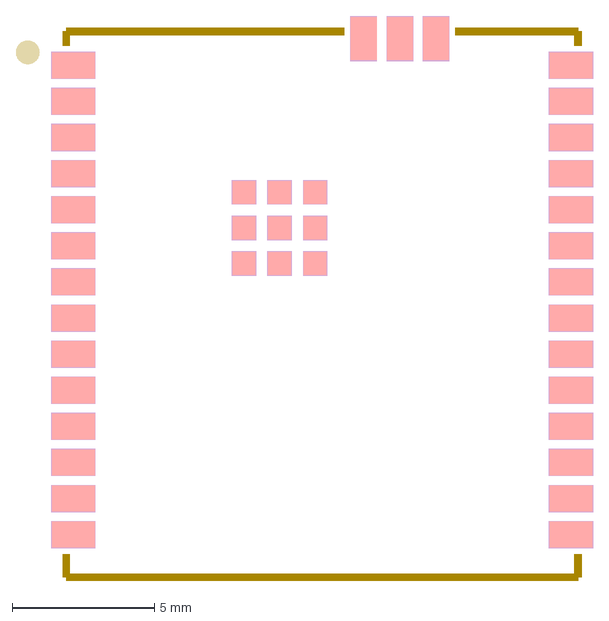
[picture p1: CAD file, 2026-04-30]
hardware/v2/CONN-SMD_ESP32-C61-WROOM-1U_2026-04-30.dxf
20.3 x 19.9 mm
