tigercraft4/SHS-Z2M-Presence/.planning/phases/01-critical-bug-fixes/01-01-SUMMARY.md

# Summary: Plan 01-01 — Mutex protection for shared state

## What Was Built
Added concurrency protection to all shared state variables accessed from multiple FreeRTOS tasks:

1. **zone_config_mutex** — New mutex protecting 31 zone configuration variables written by the Zigbee task and read by the LD2450 task
2. **volatile shs_position_reporting** — Marked volatile for atomic single-core access (toggled by button task, read by LD2450 callback)
3. **target_data_mutex wrapping shs_ld2450_target_count** — Protected read in `shs_on_state_change()` cross-validation and write in `shs_on_ld2450_target_update()`

## Key Decisions
- Mutex not held during Zigbee lock calls to avoid priority inversion between target_data_mutex and Zigbee lock
- Zone config apply function copies all variables to locals under mutex, then releases before calling LD2450 driver (avoids holding mutex during UART I/O)
- 5ms timeout on target_data_mutex (fast path), 50ms on zone_config_mutex (less frequent)

## Files Modified
- `main/shs01.c` — All changes in single file

## Commits
1. `fix(01-01): add zone_config_mutex and volatile position_reporting`
2. `fix(01-01): protect shs_ld2450_target_count with target_data_mutex`
3. `fix(01-01): protect zone config variables with zone_config_mutex`

## Requirements Addressed
- **TS-02**: shs_ld2450_target_count protected from concurrent read/write
- **TS-03**: Zone configuration variables protected with zone_config_mutex
- **TS-04**: shs_position_reporting uses volatile for safe cross-task access

## Verification
- `zone_config_mutex` appears 67 times in shs01.c (declaration, init, 31 handler wraps, apply function)
- `volatile bool shs_position_reporting` confirmed
- No nested mutex takes — each take/give is self-contained
- No IDE errors reported
