tigercraft4/SHS-Z2M-Presence/.planning/phases/01-critical-bug-fixes/01-01-PLAN.md

---
phase: 01-critical-bug-fixes
plan: 01
type: execute
wave: 1
depends_on: []
files_modified:
  - main/shs01.c
autonomous: true
requirements:
  - TS-02
  - TS-03
  - TS-04

must_haves:
  truths:
    - "shs_ld2450_target_count is never read while being written by another task"
    - "Zone configuration variables are never partially updated during sensor reads"
    - "shs_position_reporting uses volatile for atomic single-core access"
  artifacts:
    - path: "main/shs01.c"
      provides: "Thread-safe shared state access"
      contains: "zone_config_mutex"
  key_links:
    - from: "shs_on_state_change (LD2410 callback)"
      to: "shs_ld2450_target_count"
      via: "target_data_mutex take/give"
      pattern: "xSemaphoreTake\\(target_data_mutex"
    - from: "shs_zone_cfg_apply_to_sensor"
      to: "zone config variables"
      via: "zone_config_mutex take/give"
      pattern: "xSemaphoreTake\\(zone_config_mutex"
---

<objective>
Add mutex protection to shared state variables accessed from multiple FreeRTOS tasks.

Purpose: Prevent race conditions between LD2410 callback, LD2450 callback, Zigbee attribute handler, and button task. Per D-02/D-03: 2 mutexes + volatile for flags.

Output: Thread-safe access to target count, zone configuration, and position reporting flag.
</objective>

<execution_context>
@~/.copilot/get-shit-done/workflows/execute-plan.md
@~/.copilot/get-shit-done/templates/summary.md
</execution_context>

<context>
@.planning/PROJECT.md
@.planning/ROADMAP.md
@.planning/phases/01-critical-bug-fixes/01-CONTEXT.md

<interfaces>
From main/shs01.c current state:

```c
// L48 — existing mutex (initialized at L3031)
static SemaphoreHandle_t target_data_mutex = NULL;

// L187 — target count written by LD2450 callback (L963), read by LD2410 callback (L710)
static uint8_t shs_ld2450_target_count = 0;

// L126 — position reporting flag, toggled by button task, read by LD2450 callback
static bool shs_position_reporting = false;

// L215-238 — zone config variables (31 vars), written by Zigbee handler, read by zone apply
static bool    shs_zone1_enabled = false;
static int16_t shs_zone1_x1 = 0;
// ... (5 zones × 6 vars each = 30 vars + shs_zone_type global)
```
</interfaces>
</context>

<tasks>

<task type="auto">
  <name>Task 1: Create zone_config_mutex and add volatile to position_reporting</name>
  <files>main/shs01.c</files>
  <read_first>
    - main/shs01.c (L48 for target_data_mutex declaration, L126 for shs_position_reporting, L3020-3070 for app_main init order)
  </read_first>
  <action>
1. Add `zone_config_mutex` declaration near L48 (after `target_data_mutex`):
   ```c
   static SemaphoreHandle_t zone_config_mutex = NULL;
   ```

2. Change `shs_position_reporting` declaration (around L126) from:
   ```c
   static bool shs_position_reporting = false;
   ```
   to:
   ```c
   static volatile bool shs_position_reporting = false;
   ```

3. In `app_main()` (around L3031), after `target_data_mutex` creation, add:
   ```c
   zone_config_mutex = xSemaphoreCreateMutex();
   if (zone_config_mutex == NULL) {
       ESP_LOGE(SHS_TAG, "Failed to create zone config mutex");
   }
   ```
  </action>
  <verify>
    <automated>grep -n "zone_config_mutex" main/shs01.c | head -5</automated>
  </verify>
  <acceptance_criteria>
    - main/shs01.c contains `static SemaphoreHandle_t zone_config_mutex = NULL;`
    - main/shs01.c contains `static volatile bool shs_position_reporting`
    - main/shs01.c contains `zone_config_mutex = xSemaphoreCreateMutex()`
    - zone_config_mutex creation appears BEFORE any task creation (`xTaskCreate`) in app_main
  </acceptance_criteria>
  <done>zone_config_mutex declared, initialized in app_main before tasks start. shs_position_reporting is volatile.</done>
</task>

<task type="auto">
  <name>Task 2: Protect shs_ld2450_target_count with target_data_mutex (TS-02)</name>
  <files>main/shs01.c</files>
  <read_first>
    - main/shs01.c (L700-720 for shs_on_state_change target_count read, L950-970 for shs_on_ld2450_target_update target_count write)
  </read_first>
  <action>
1. In `shs_on_state_change()` (LD2410 callback, around L710), wrap the `shs_ld2450_target_count` read:
   ```c
   // Before the cross-validation block, read target count under mutex
   uint8_t ld2450_count = 0;
   if (xSemaphoreTake(target_data_mutex, pdMS_TO_TICKS(5)) == pdTRUE) {
       ld2450_count = shs_ld2450_target_count;
       xSemaphoreGive(target_data_mutex);
   }
   ```
   Then replace `if (shs_ld2450_target_count == 0)` with `if (ld2450_count == 0)`.

2. In `shs_on_ld2450_target_update()` (around L963), the write to `shs_ld2450_target_count` is already inside a section that uses Zigbee lock. Wrap the target_count update with target_data_mutex:
   ```c
   if (xSemaphoreTake(target_data_mutex, pdMS_TO_TICKS(5)) == pdTRUE) {
       shs_ld2450_target_count = effective_count;
       xSemaphoreGive(target_data_mutex);
   }
   ```
   Note: The existing `current_targets[]` copy at L984-996 already uses `target_data_mutex` — do NOT nest the takes. Place the target_count mutex block BEFORE the existing `current_targets` copy block.
  </action>
  <verify>
    <automated>grep -A2 "ld2450_count" main/shs01.c | head -10</automated>
  </verify>
  <acceptance_criteria>
    - main/shs01.c contains `ld2450_count = shs_ld2450_target_count` inside a `xSemaphoreTake(target_data_mutex` block
    - main/shs01.c contains `if (ld2450_count == 0)` replacing the unprotected read
    - The target_count write in shs_on_ld2450_target_update is inside a `xSemaphoreTake(target_data_mutex` block
    - No nested mutex takes (target_count mutex block separate from current_targets mutex block)
  </acceptance_criteria>
  <done>shs_ld2450_target_count reads and writes protected by target_data_mutex. No stale cross-validation data.</done>
</task>

<task type="auto">
  <name>Task 3: Protect zone config variables with zone_config_mutex (TS-03)</name>
  <files>main/shs01.c</files>
  <read_first>
    - main/shs01.c (L1665-1700 for Zigbee zone attribute handler, L530-590 for shs_zone_cfg_apply_to_sensor zone var reads)
  </read_first>
  <action>
1. In the Zigbee attribute write handler (the large switch block starting around L1671), wrap each zone variable write with zone_config_mutex. Since each case returns immediately with `return ESP_OK`, wrap each case body:
   ```c
   case SHS_ATTR_ZONE1_ENABLED:
       if (xSemaphoreTake(zone_config_mutex, pdMS_TO_TICKS(50)) == pdTRUE) {
           shs_zone1_enabled = (v8 != 0);
           xSemaphoreGive(zone_config_mutex);
       }
       ESP_LOGI(SHS_TAG, "Zone 1 Enabled = %d", shs_zone1_enabled);
       shs_zone_cfg_schedule_apply();
       return ESP_OK;
   ```
   Apply the same pattern to ALL zone attribute cases (zone 1-5: ENABLED, X1, Y1, X2, Y2, TYPE = 30 cases total, plus ZONE_TYPE_CFG global).

2. In `shs_zone_cfg_apply_to_sensor()` (around L530-590), wrap the entire zone variable read block with zone_config_mutex. Take the mutex at the start of the function, copy all zone values to local variables, release the mutex, then use local copies for the rest of the function:
   ```c
   // At start of shs_zone_cfg_apply_to_sensor():
   bool z1_en, z2_en, z3_en, z4_en, z5_en;
   int16_t z1_x1, z1_y1, z1_x2, z1_y2; // ... etc for all zones
   uint8_t z1_type, z2_type, z3_type, z4_type, z5_type;
   uint8_t zone_type_local;

   if (xSemaphoreTake(zone_config_mutex, pdMS_TO_TICKS(50)) == pdTRUE) {
       zone_type_local = shs_zone_type;
       z1_en = shs_zone1_enabled; z1_x1 = shs_zone1_x1; // ... copy all
       xSemaphoreGive(zone_config_mutex);
   } else {
       ESP_LOGW(SHS_TAG, "Zone config mutex timeout - skipping apply");
       return;
   }
   // Use local copies for ld2450_set_zone calls and logging
   ```
  </action>
  <verify>
    <automated>grep -c "zone_config_mutex" main/shs01.c</automated>
  </verify>
  <acceptance_criteria>
    - main/shs01.c contains `xSemaphoreTake(zone_config_mutex` in BOTH the Zigbee attribute handler AND shs_zone_cfg_apply_to_sensor
    - Zone variable writes in attribute handler are wrapped with zone_config_mutex take/give
    - shs_zone_cfg_apply_to_sensor copies zone vars to locals under mutex before using them
    - grep count of `zone_config_mutex` is >= 35 (31 handler wraps + mutex create + declare + apply function take/give)
  </acceptance_criteria>
  <done>Zone config vars protected from concurrent read/write. No partial zone config applied during Zigbee updates.</done>
</task>

</tasks>

<threat_model>
## Trust Boundaries

| Boundary | Description |
|---|---|
| Task→SharedState | Multiple FreeRTOS tasks access shared globals |

## STRIDE Threat Register

| Threat ID | Category | Component | Disposition | Mitigation Plan |
|---|---|---|---|---|
| T-01-01 | T (Tampering) | shared state | mitigate | Mutex protection on all multi-task variables |
| T-01-02 | D (DoS) | mutex deadlock | accept | Single-core MCU with timeout — deadlock causes task stall not system crash; watchdog in Phase 3 will catch |
</threat_model>

<verification>
- `idf.py build` compiles without errors or warnings
- grep confirms `zone_config_mutex` and `volatile bool shs_position_reporting` present
- No nested mutex takes (each take/give pair is self-contained)
</verification>

<success_criteria>
All shared state between FreeRTOS tasks is protected by appropriate synchronization primitive (mutex or volatile).
</success_criteria>

<output>
After completion, create `.planning/phases/01-critical-bug-fixes/01-01-SUMMARY.md`
</output>
