tigercraft4/SHS-Z2M-Presence/.planning/phases/01-critical-bug-fixes/01-02-PLAN.md

---
phase: 01-critical-bug-fixes
plan: 02
type: execute
wave: 2
depends_on: [01-01]
files_modified:
  - main/shs01.c
autonomous: true
requirements:
  - ZB-01
  - ZB-02
  - NVS-01

must_haves:
  truths:
    - "Zigbee lock failures are retried 3 times before giving up"
    - "Zone NVS saves happen in the save_worker task, not in sensor/Zigbee callback context"
    - "Lock diagnostic counters accurately track retry attempts"
  artifacts:
    - path: "main/shs01.c"
      provides: "Retry-enabled Zigbee lock macros and zone save routing"
      contains: "SHS_SAVE_ZONE_CONFIG"
  key_links:
    - from: "SHS_ZB_LOCK_ACQUIRE_OR_RETURN macro"
      to: "esp_zb_lock_acquire"
      via: "retry loop with backoff"
      pattern: "for.*retry.*esp_zb_lock_acquire"
    - from: "shs_zone_cfg_apply_to_sensor"
      to: "shs_save_worker"
      via: "xQueueSend(shs_save_q"
      pattern: "SHS_SAVE_ZONE_CONFIG"
---

<objective>
Add exponential backoff retry to Zigbee lock macros and route zone NVS saves through the existing save_worker task.

Purpose: Prevent silent data loss from lock failures (per D-04) and remove NVS blocking from sensor/Zigbee callback context (per D-06).

Output: Retry-enabled lock macros, zone save integration in save_worker.
</objective>

<execution_context>
@~/.copilot/get-shit-done/workflows/execute-plan.md
@~/.copilot/get-shit-done/templates/summary.md
</execution_context>

<context>
@.planning/PROJECT.md
@.planning/ROADMAP.md
@.planning/phases/01-critical-bug-fixes/01-CONTEXT.md

<interfaces>
From main/shs01.c current state:

```c
// L148-180 — Current lock macros (no retry, instant return on failure)
#define SHS_ZB_LOCK_ACQUIRE_OR_RETURN() \
    do { \
        if (esp_zb_lock_acquire(pdMS_TO_TICKS(SHS_ZB_LOCK_TIMEOUT_MS)) != true) { \
            shs_lock_fail_count++; \
            shs_lock_consecutive_fails++; \
            // ... log and return \
            return; \
        } \
        shs_lock_success_count++; \
        shs_lock_consecutive_fails = 0; \
    } while(0)

// L260-273 — Save worker message types
typedef enum {
    SHS_SAVE_IMMEDIATE_U16,
    SHS_SAVE_DEBOUNCE_SENS_MOVE,
    SHS_SAVE_DEBOUNCE_SENS_STATIC,
    SHS_SAVE_DEBOUNCE_GATE_MOVE,
    SHS_SAVE_DEBOUNCE_GATE_STATIC,
} shs_save_evt_t;

typedef struct {
    shs_save_evt_t type;
    uint16_t       u16;
} shs_save_msg_t;

// L307-311 — Save enqueue helper
static inline void shs_save_enqueue(shs_save_evt_t t, uint16_t v) {
    if (!shs_save_q) return;
    shs_save_msg_t m = {.type = t, .u16 = v};
    (void)xQueueSend(shs_save_q, &m, 0);
}

// L585-588 — Zone save call site (currently direct, needs routing)
if (shs_zone_cfg_save_needed) {
    shs_zone_cfg_save_to_nvs();
    shs_zone_cfg_save_needed = false;
}
```
</interfaces>
</context>

<tasks>

<task type="auto">
  <name>Task 1: Replace Zigbee lock macros with retry-enabled versions (ZB-01, ZB-02)</name>
  <files>main/shs01.c</files>
  <read_first>
    - main/shs01.c (L140-180 for current SHS_ZB_LOCK_ACQUIRE_OR_RETURN and SHS_ZB_LOCK_ACQUIRE_OR_RETURN_FALSE macros, L148 for SHS_ZB_LOCK_TIMEOUT_MS)
  </read_first>
  <action>
Replace both lock macros at L148-180 with retry versions. Per D-04: 3 attempts, exponential backoff 50ms→100ms→200ms.

Replace `SHS_ZB_LOCK_ACQUIRE_OR_RETURN()` with:
```c
#define SHS_ZB_LOCK_ACQUIRE_OR_RETURN() \
    do { \
        bool _lock_ok = false; \
        static const TickType_t _backoff[] = { \
            pdMS_TO_TICKS(50), pdMS_TO_TICKS(100), pdMS_TO_TICKS(200) \
        }; \
        for (int _try = 0; _try < 3; _try++) { \
            if (esp_zb_lock_acquire(_backoff[_try]) == true) { \
                _lock_ok = true; \
                break; \
            } \
            ESP_LOGD(SHS_TAG, "Zigbee lock retry %d/3", _try + 1); \
        } \
        if (!_lock_ok) { \
            shs_lock_fail_count++; \
            shs_lock_consecutive_fails++; \
            if (shs_lock_consecutive_fails == 1 || shs_lock_consecutive_fails == 10 || \
                shs_lock_consecutive_fails == 50 || (shs_lock_consecutive_fails % 100) == 0) { \
                ESP_LOGW(SHS_TAG, "Zigbee lock FAILED after 3 retries #%lu (consecutive: %lu)", \
                         (unsigned long)shs_lock_fail_count, (unsigned long)shs_lock_consecutive_fails); \
            } \
            return; \
        } \
        shs_lock_success_count++; \
        shs_lock_consecutive_fails = 0; \
    } while(0)
```

Replace `SHS_ZB_LOCK_ACQUIRE_OR_RETURN_FALSE()` with identical logic but `return false` instead of `return`.

Remove the `#define SHS_ZB_LOCK_TIMEOUT_MS 100` constant (no longer needed — timeouts are in the backoff array).
  </action>
  <verify>
    <automated>grep -c "backoff\|retry" main/shs01.c</automated>
  </verify>
  <acceptance_criteria>
    - main/shs01.c contains `_backoff[] = {` with values `pdMS_TO_TICKS(50), pdMS_TO_TICKS(100), pdMS_TO_TICKS(200)`
    - main/shs01.c contains `for (int _try = 0; _try < 3; _try++)`
    - main/shs01.c contains `Zigbee lock FAILED after 3 retries` log message
    - BOTH macro variants (RETURN and RETURN_FALSE) have the retry loop
    - `SHS_ZB_LOCK_TIMEOUT_MS` constant is removed or no longer used in the macros
    - `shs_lock_success_count` and `shs_lock_consecutive_fails` counters still updated correctly
  </acceptance_criteria>
  <done>Both Zigbee lock macros retry 3x with exponential backoff before giving up. No silent data loss on transient lock contention.</done>
</task>

<task type="auto">
  <name>Task 2: Route zone NVS saves through save_worker (NVS-01)</name>
  <files>main/shs01.c</files>
  <read_first>
    - main/shs01.c (L260-273 for shs_save_evt_t and shs_save_msg_t, L307-311 for shs_save_enqueue, L580-590 for zone save call site, L2962-3010 for shs_save_worker task)
  </read_first>
  <action>
1. Add `SHS_SAVE_ZONE_CONFIG` to the `shs_save_evt_t` enum (after SHS_SAVE_DEBOUNCE_GATE_STATIC):
   ```c
   typedef enum {
       SHS_SAVE_IMMEDIATE_U16,
       SHS_SAVE_DEBOUNCE_SENS_MOVE,
       SHS_SAVE_DEBOUNCE_SENS_STATIC,
       SHS_SAVE_DEBOUNCE_GATE_MOVE,
       SHS_SAVE_DEBOUNCE_GATE_STATIC,
       SHS_SAVE_ZONE_CONFIG,
   } shs_save_evt_t;
   ```

2. In `shs_zone_cfg_apply_to_sensor()` (around L585-588), replace the direct NVS call:
   FROM:
   ```c
   if (shs_zone_cfg_save_needed) {
       shs_zone_cfg_save_to_nvs();
       shs_zone_cfg_save_needed = false;
   }
   ```
   TO:
   ```c
   if (shs_zone_cfg_save_needed) {
       shs_save_enqueue(SHS_SAVE_ZONE_CONFIG, 0);
       shs_zone_cfg_save_needed = false;
   }
   ```

3. In `shs_save_worker()` (around L2975), add a case for the new message type inside the switch statement:
   ```c
   case SHS_SAVE_ZONE_CONFIG:
       shs_zone_cfg_save_to_nvs();
       ESP_LOGI(SHS_TAG, "Zone config saved to NVS (via worker)");
       break;
   ```
   Place this after the existing `SHS_SAVE_DEBOUNCE_GATE_STATIC` case but before the closing brace of the switch.
  </action>
  <verify>
    <automated>grep -n "SHS_SAVE_ZONE_CONFIG" main/shs01.c</automated>
  </verify>
  <acceptance_criteria>
    - main/shs01.c contains `SHS_SAVE_ZONE_CONFIG` in the shs_save_evt_t enum
    - main/shs01.c contains `shs_save_enqueue(SHS_SAVE_ZONE_CONFIG, 0)` in the zone apply function
    - main/shs01.c contains `case SHS_SAVE_ZONE_CONFIG:` in shs_save_worker
    - The direct call `shs_zone_cfg_save_to_nvs()` in shs_zone_cfg_apply_to_sensor is REMOVED (only called from save_worker now)
    - grep for `SHS_SAVE_ZONE_CONFIG` returns exactly 3 matches (enum, enqueue call, case handler)
  </acceptance_criteria>
  <done>Zone NVS saves routed through save_worker task. No NVS blocking in Zigbee/sensor callback context.</done>
</task>

</tasks>

<threat_model>
## Trust Boundaries

| Boundary | Description |
|---|---|
| Task→ZigbeeStack | Sensor tasks acquire Zigbee lock for attribute updates |
| Task→NVSFlash | Zone config saves trigger flash writes |

## STRIDE Threat Register

| Threat ID | Category | Component | Disposition | Mitigation Plan |
|---|---|---|---|---|
| T-01-03 | D (DoS) | Zigbee lock retry | mitigate | Cap retries at 3 with 350ms total max wait; after 3 failures, return (no infinite loop) |
| T-01-04 | I (Info Disclosure) | NVS save timing | accept | Zone config is not sensitive data; timing side-channel irrelevant |
| T-01-05 | T (Tampering) | save queue overflow | accept | Queue depth 16; zone saves rare (only on user config change); overflow drops save, not data |
</threat_model>

<verification>
- `idf.py build` compiles without errors or warnings
- grep confirms `_backoff[]` array in both lock macros
- grep confirms `SHS_SAVE_ZONE_CONFIG` appears 3 times (enum + enqueue + case)
- No direct call to `shs_zone_cfg_save_to_nvs()` outside of `shs_save_worker`
</verification>

<success_criteria>
Zigbee lock failures are retried with backoff, and zone NVS saves run in the save_worker context (priority 3) instead of blocking higher-priority tasks.
</success_criteria>

<output>
After completion, create `.planning/phases/01-critical-bug-fixes/01-02-SUMMARY.md`
</output>
