tigercraft4/SHS-Z2M-Presence/(list of files, drawings)

Other design files:
hardware/v1/SHS-Z2M-Presence.dsn
