tigercraft4/SHS-Z2M-Presence/hardware/v1/SHS-Z2M-Presence.kicad_pcb

## KiCad design hardware/v1/SHS-Z2M-Presence.kicad_pcb (2026-04-30, an earlier design)

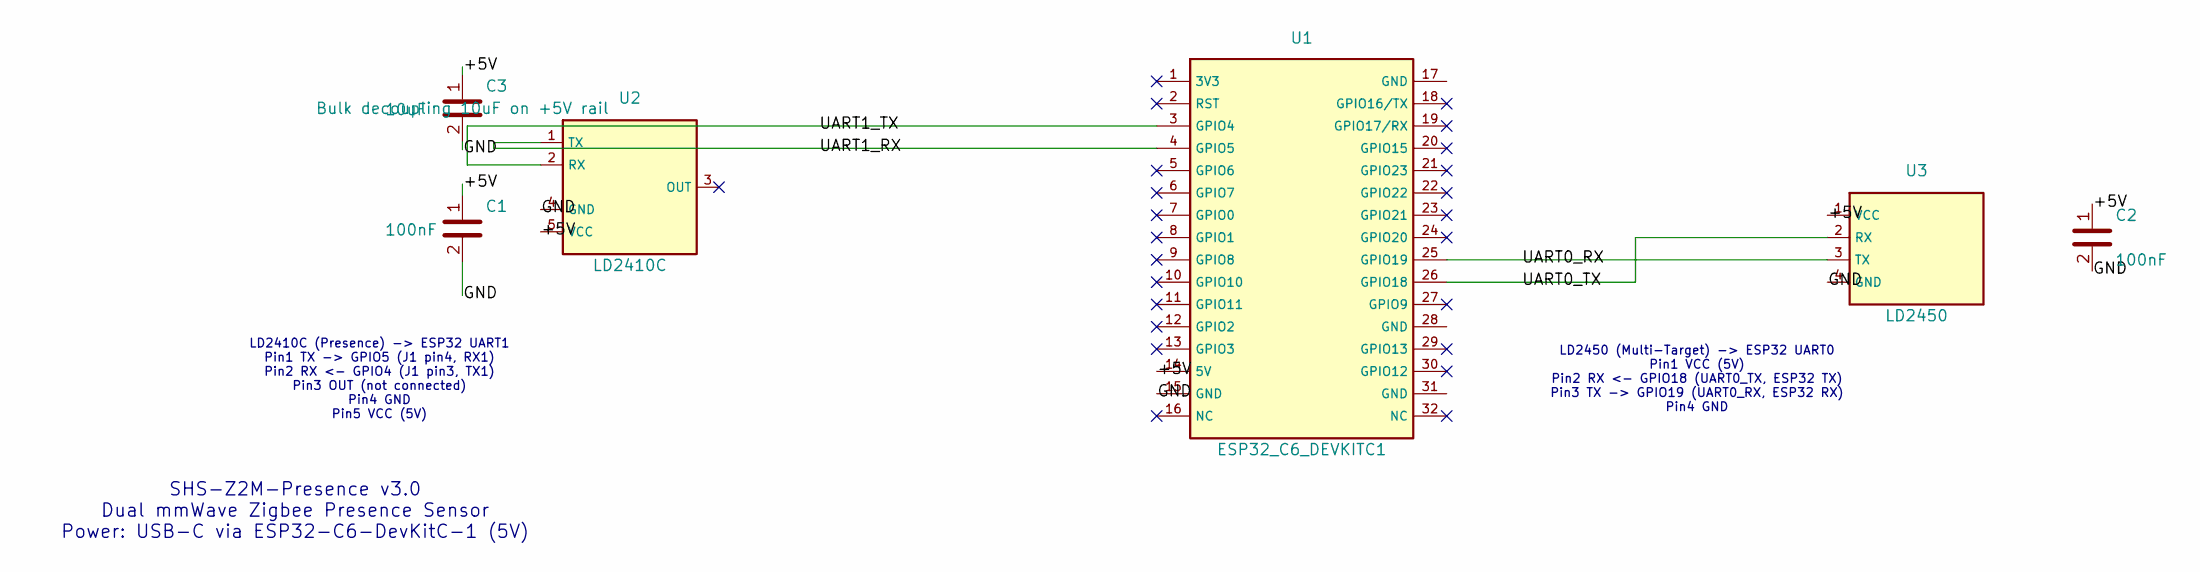
[picture p2: schematic SHS-Z2M-Presence.kicad_sch, SHS-Z2M-Presence Dual mmWave Sensor]

Parts:
C1, C2: 100nF; C_0805_2012Metric; MPN CL21B104KACNNNC
C3: 10uF; C_0805_2012Metric; MPN GRM21BR61A106KE18L
U1: ESP32_C6_DEVKITC1; MPN ESP32-C6-DEVKITC-1-N8
U2: LD2410C; MPN LD2410C
U3: LD2450; MPN LD2450

Connections:
+5V: C1.1, C2.1, C3.1, U1.14 (5V), U2.5 (VCC), U3.1 (VCC)
GND: C1.2, C2.2, C3.2, U1.15 (GND), U1.17 (GND), U1.28 (GND), U1.31 (GND), U2.4 (GND), U3.4 (GND)
UART0_RX: U1.25 (GPIO19), U3.3 (TX)
UART0_TX: U1.26 (GPIO18), U3.2 (RX)
UART1_RX: U1.3 (GPIO4), U2.2 (RX)
UART1_TX: U1.4 (GPIO5), U2.1 (TX)

Notes on the sheet:
SHS-Z2M-Presence v3.0 Dual mmWave Zigbee Presence Sensor Power: USB-C via ESP32-C6-DevKitC-1 (5V)
LD2410C (Presence) -> ESP32 UART1 Pin1 TX -> GPIO5 (J1 pin4, RX1) Pin2 RX <- GPIO4 (J1 pin3, TX1) Pin3 OUT (not connected) Pin4 GND Pin5 VCC (5V)
LD2450 (Multi-Target) -> ESP32 UART0 Pin1 VCC (5V) Pin2 RX <- GPIO18 (UART0_TX, ESP32 TX) Pin3 TX -> GPIO19 (UART0_RX, ESP32 RX) Pin4 GND

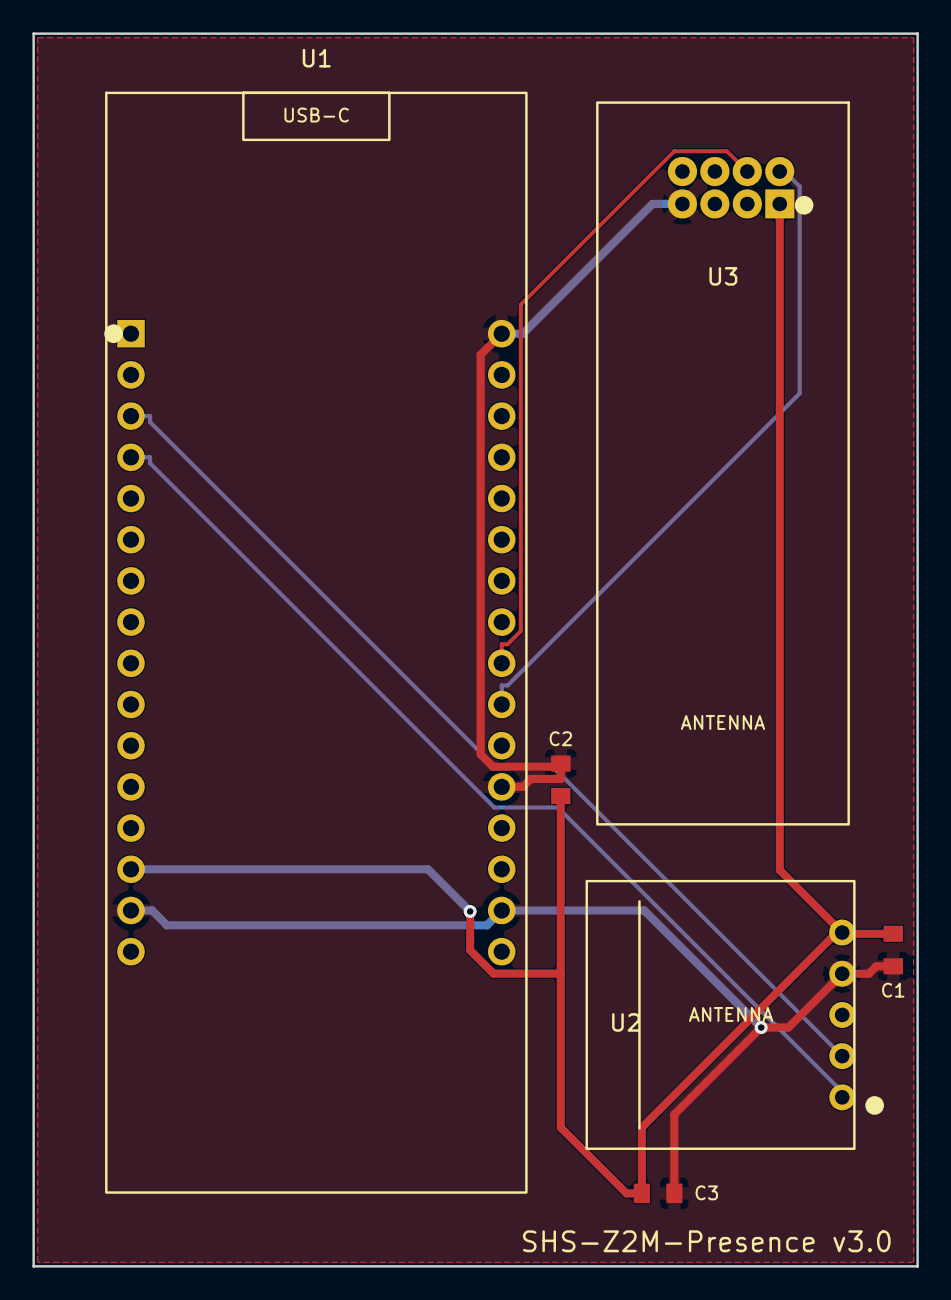
[picture p3: board SHS-Z2M-Presence.kicad_pcb from above]

Board: 2 copper layers, 54.5 x 76.0 mm, 6 parts (0 on the bottom side), 6 nets.
