tigercraft4/SHS-Z2M-Presence/(commit log)

2026-04-30 Add KiCad PCB hardware designs (v1 and v2)
    v1: Original PCB with ESP32-C6 + LD2410C + LD2450, fabricated and tested
    v2: Redesigned standalone board (work in progress, routing not started)
    [BOM_JLCPCB.csv, CONN-SMD_ESP32-C61-WROOM-1U_2026-04-30.dxf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]
2026-04-30 Add PCB design notes with v1/v2 analysis and layout decisions
2026-04-30 Fix v2 schematic issues: LEDs, ESD, caps, EN pin, fiducials
    - Fix LED1/LED2 rotation for correct pin-wire alignment and polarity
    - Fix U4 (AP2112K) EN pin wire — was 5mm misaligned from actual pin
    - Change C3/C5/C7 from 0402 to 0805 to avoid 10uF voltage derating
    - Add U5 USBLC6-2SC6 for USB ESD protection
    - Add FID1-FID3 fiducial markers for SMD assembly
    - Remove TP1-TP8 test points and H1-H4 mounting holes (not needed)
    - Update DESIGN-NOTES.md with fix status and revised component table
    Components reduced from 36 to 28, findings from 44 to 31.
    [SHS-Z2M-Presence-v2.kicad_sch]
2026-04-30 fix(01-01): add zone_config_mutex and volatile position_reporting
    - Declare zone_config_mutex after target_data_mutex
    - Initialize zone_config_mutex in app_main before task creation
    - Mark shs_position_reporting as volatile for atomic single-core access
    [shs01.c]
2026-04-30 fix(01-01): protect shs_ld2450_target_count with target_data_mutex
    - Read target count under mutex in shs_on_state_change cross-validation
    - Read/write target count under mutex in shs_on_ld2450_target_update
    - No nested mutex takes — each take/give is self-contained
    - Mutex not held during Zigbee lock calls to avoid priority inversion
    [shs01.c]
2026-04-30 fix(01-01): protect zone config variables with zone_config_mutex
    - Wrap all 31 zone attribute writes in Zigbee handler with zone_config_mutex
    - Copy zone vars to locals under mutex in shs_zone_cfg_apply_to_sensor
    - Prevents partial zone config reads during concurrent Zigbee attribute updates
    - Mutex timeout returns early with warning log (no deadlock risk)
    [shs01.c]
2026-04-30 fix(01-02): replace Zigbee lock macros with retry + exponential backoff
    - 3 attempts with backoff: 50ms, 100ms, 200ms (350ms total max wait)
    - Both RETURN and RETURN_FALSE variants have retry loop
    - Log message updated to 'FAILED after 3 retries' for clarity
    - Kept SHS_ZB_LOCK_TIMEOUT_MS for one-off lock acquire in boot button handler
    [shs01.c]
2026-04-30 fix(01-02): route zone NVS saves through save_worker task
    - Add SHS_SAVE_ZONE_CONFIG to save event enum
    - Replace direct shs_zone_cfg_save_to_nvs() call with shs_save_enqueue()
    - Add case handler in shs_save_worker for zone config saves
    - NVS writes now happen at priority 3 instead of blocking sensor/Zigbee callbacks
    [shs01.c]
2026-04-30 docs(02): create phase plan for sensor filters and converter fix
2026-04-30 feat(02-01): add LD2410C standalone filter when LD2450 disconnected
2026-04-30 docs(phase-02): complete phase execution — verification passed
2026-04-30 Rewrite v2 PCB layout: compact 39x49mm 4-layer board
    - Board outline reduced from 100x70mm to 39x49mm (73% area reduction)
    - 4-layer stackup: F.Cu (sensors), In1.Cu (GND plane), In2.Cu (+3V3), B.Cu (SMD)
    - Sensors (LD2410C, LD2450) placed on F.Cu with THT headers
    - All SMD components (ESP32, LDO, USB-C, passives) on B.Cu
    - GND zones on F.Cu, In1.Cu, B.Cu; +3V3 power plane on In2.Cu
    - Fiducials at 3 corners for SMD assembly
    - Update DESIGN-NOTES.md with 4-layer decision and board dimensions
    - Add .history/ to .gitignore (KiCad local undo history)
    [SHS-Z2M-Presence-v2.kicad_pcb]
2026-04-30 Remove all tracks from v2 PCB for clean rerouting
    Strip 134 auto-generated segments — board is now unrouted
    and ready for interactive routing in KiCad.
    [SHS-Z2M-Presence-v2.kicad_pcb]
2026-04-30 Strip all net assignments from v2 PCB for clean reimport
    Remove 91 net references from pads and zones so KiCad can
    reassign everything fresh via Update PCB from Schematic (F8).
    [SHS-Z2M-Presence-v2.kicad_pcb]
2026-04-30 Fix schematic wire gaps and restore PCB zone nets
    Schematic fixes:
    - Fix SW1/SW2 wire endpoints (0.032mm gap: 98.952→98.92, etc.)
    Both switches now correctly connect to ESP_EN/BOOT and GND
    - Replace SW1-to-ESP_EN wire through C8 GND area with direct
    ESP_EN label (avoids T-junction short with GND)
    - Add direct +5V label on U4.EN wire (avoids T-junction
    dependency through IN pin at same x-coordinate)
    PCB fixes:
    - Restore zone net assignments stripped during net cleanup:
    F.Cu=GND, B.Cu=GND, In1.Cu=GND, In2.Cu=+3V3
    [SHS-Z2M-Presence-v2.kicad_pcb, SHS-Z2M-Presence-v2.kicad_sch]
2026-04-30 feat(03-01): add task watchdog + LD2410C frame disconnect detection
    - Enable ESP-IDF TWDT with 10s timeout and panic-on-trigger
    - Subscribe both sensor tasks (ld2410, ld2450) to TWDT
    - Add esp_task_wdt_reset() in both sensor task loops
    - Add LD2410C frame timestamp tracking with 3s disconnect threshold
    - Disable idle task monitoring (single-core ESP32-C6 may starve under Zigbee)
2026-04-30 feat(03-01): NVS zone config atomic blob + error logging
    - Replace 31 individual NVS writes with single nvs_set_blob (51 bytes)
    - Add shs_zone_cfg_blob_t packed struct for atomic save
    - Load tries blob first, falls back to legacy per-key format
    - Legacy configs auto-migrate to blob on first boot
    - Add ESP_LOGW to NVS helper functions on open failure
    [shs01.c]
2026-04-30 feat(03-02): add Z2M converter decode for health + diagnostic attributes
    - Add 9 attribute constants (0x0070-0x0071, 0x0080-0x0086) to both .js and .mjs
    - Add fromZigbee decode for health booleans and diagnostic counters
    - Add exposes: 2 binary (sensor connected) + 7 numeric (lock/TX/uptime/heap)
    - Add configure read for initial attribute values on interview
    - Both .js and .mjs files updated identically
2026-04-30 docs(phase-3): complete phase execution — reliability & diagnostics
2026-04-30 docs(04): create phase plan — 3 plans in 3 waves
2026-04-30 refactor(04-03): split shs01.c into config/sensor/button modules, slim app_main
    - shs_config.h/c: NVS load/save, zone blob format, computed zone attr handler (CS-03), save_worker task, LD2410 config apply
    - shs_sensor.h/c: LD2410/LD2450 tasks, target callbacks, zone occupancy with loops, position smoothing, connectivity monitoring
    - shs_button.h/c: boot button task with triple/quad-click detection, factory reset, LED feedback
    - shs01.c: 85-line app_main — NVS init, state init, module inits, driver inits, 5x xTaskCreate
    - shs01.h: added shared constants (ZB lock timeout, button timing, LD2410C frame timeout)
    - shs_zigbee.h/c: added shs_zb_schedule_rejoin(), removed duplicate SHS_ZB_LOCK_TIM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
    [shs01.c, shs01.h, shs_button.c, shs_button.h, shs_config.c, shs_config.h, shs_sensor.c, shs_sensor.h]
2026-05-04 fix: ESP-IDF v6.0.1 build compatibility
    - Add esp_driver_uart to ld2410_enhanced deps
    - Add esp_driver_uart/gpio to ld2450 deps
    - Cast volatile bool* to void* for ZB API calls (GCC 15 -Werror=discarded-qualifiers)
    - Add const to zcl_utility manufacturer_info param
    [shs_button.c, shs_zigbee.c]
